epvario/epvario.github.io/downloads/hardware/index.html

EPV

- Introduction
- Features
- Usage
- Configurator
- Build Instructions
- Downloads
- GitHub (https://github.com/epvario)

### Case, Backplates, Buttons:

- printable Case STL Files (https://github.com/epvario/hardware/tree/main/rev3)

### Hardware Files:

- download Gerber / Production Files / BOM / xwCPL (https://github.com/epvario/hardware/tree/main/rev3/production_files)

### PCB Design Files:

- download KiCad Design files (https://github.com/epvario/hardware/tree/main/rev3/kiCad)
- PCB Layout reference (https://github.com/epvario/hardware/tree/main/rev3/layout)

#### ON THIS PAGE

- Case, Backplates, Buttons: (https://epvario.github.io/downloads/hardware/#case-backplates-buttons)
- Hardware Files: (https://epvario.github.io/downloads/hardware/#hardware-files)
- PCB Design Files: (https://epvario.github.io/downloads/hardware/#pcb-design-files)
- Introduction (https://epvario.github.io/introduction)
- Features (https://epvario.github.io/features)
- Build Instructions (https://epvario.github.io/buildinstructions)
- Usage (https://epvario.github.io/usage)
- How To (https://epvario.github.io/howto)
- Configurator (https://epvario.github.io/config)
- Downloads (https://epvario.github.io/downloads)
  - Firmware (https://epvario.github.io/downloads/firmware)
  - AGL Data (https://epvario.github.io/downloads/agl)
  - Hardware (https://epvario.github.io/downloads/hardware)

Powered by Zola (https://www.getzola.org) and Goyo (https://github.com/hahwul/goyo)
