epvario/epvario.github.io/images/EP_flight.jpg

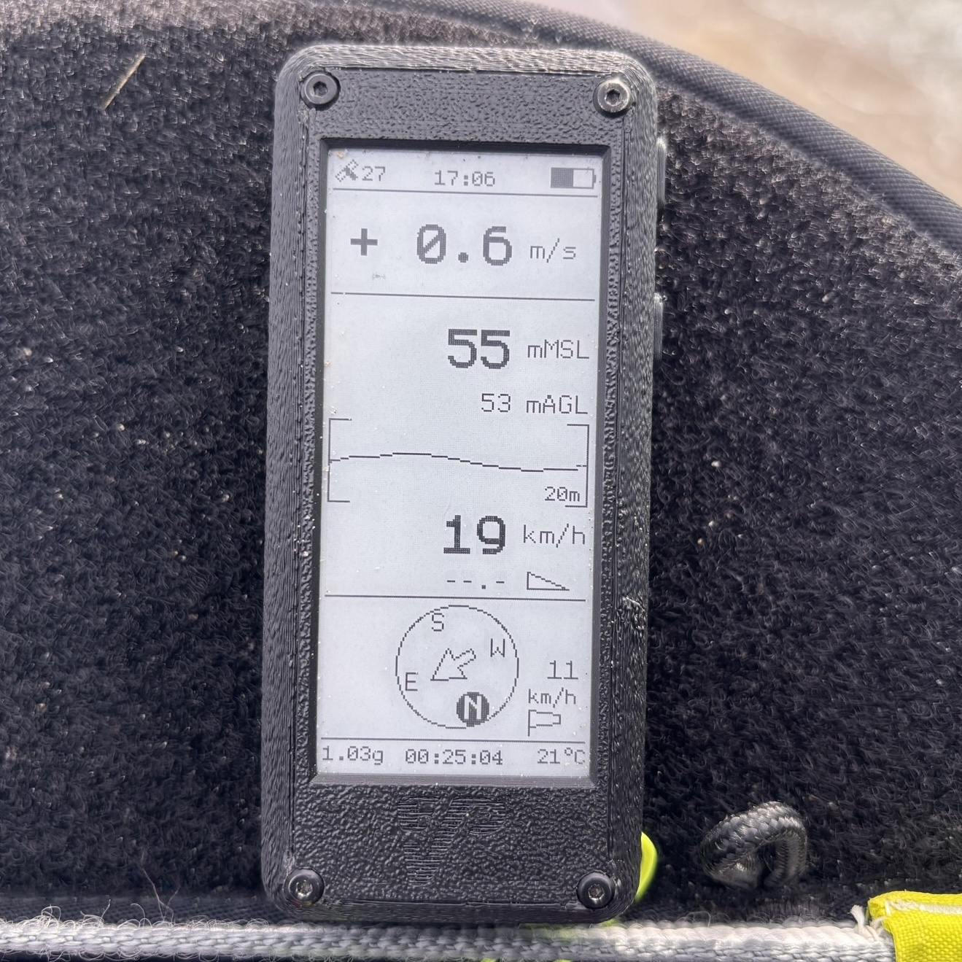
images/EP_flight.jpg
