epvario/epvario.github.io/images/EP_stats.jpg

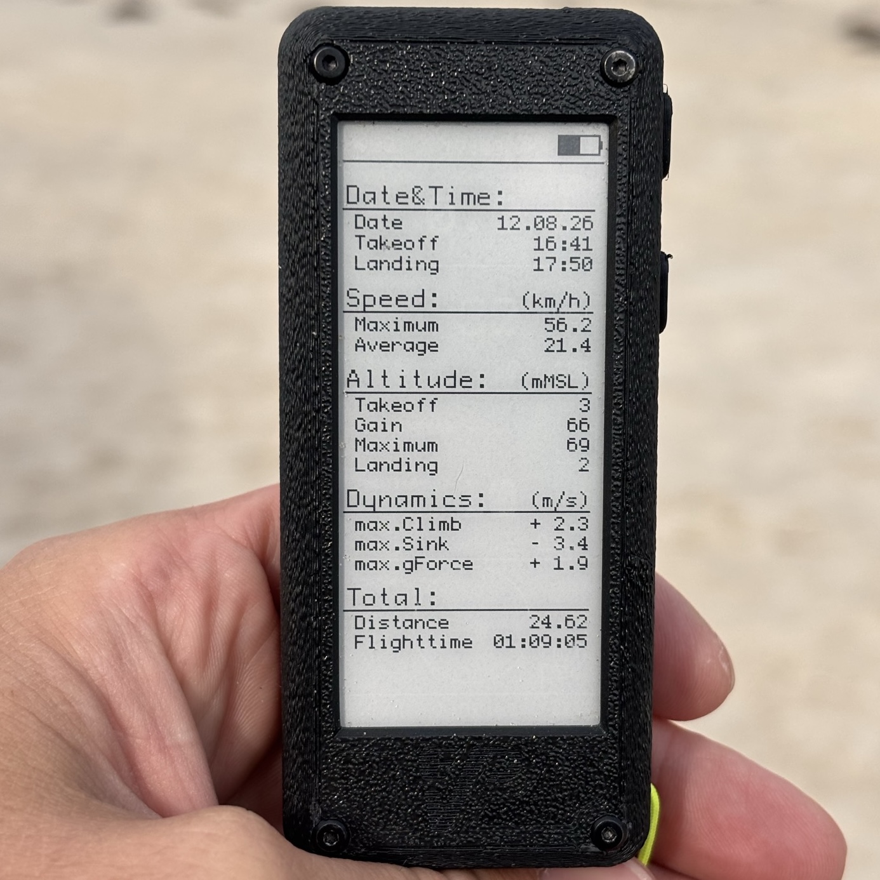
images/EP_stats.jpg
