epvario/epvario.github.io/images/epv-inflight.jpg

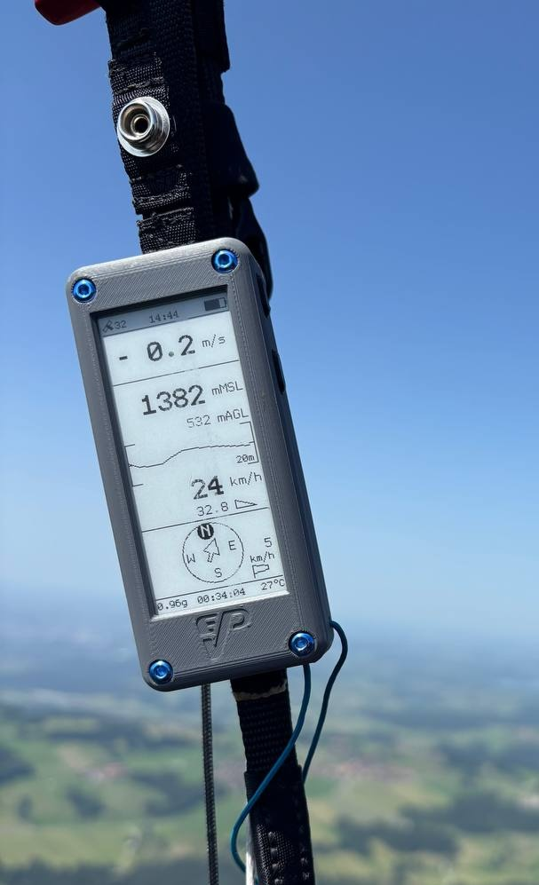
images/epv-inflight.jpg
