epvario/epvario.github.io/images/epv_display_elements.png

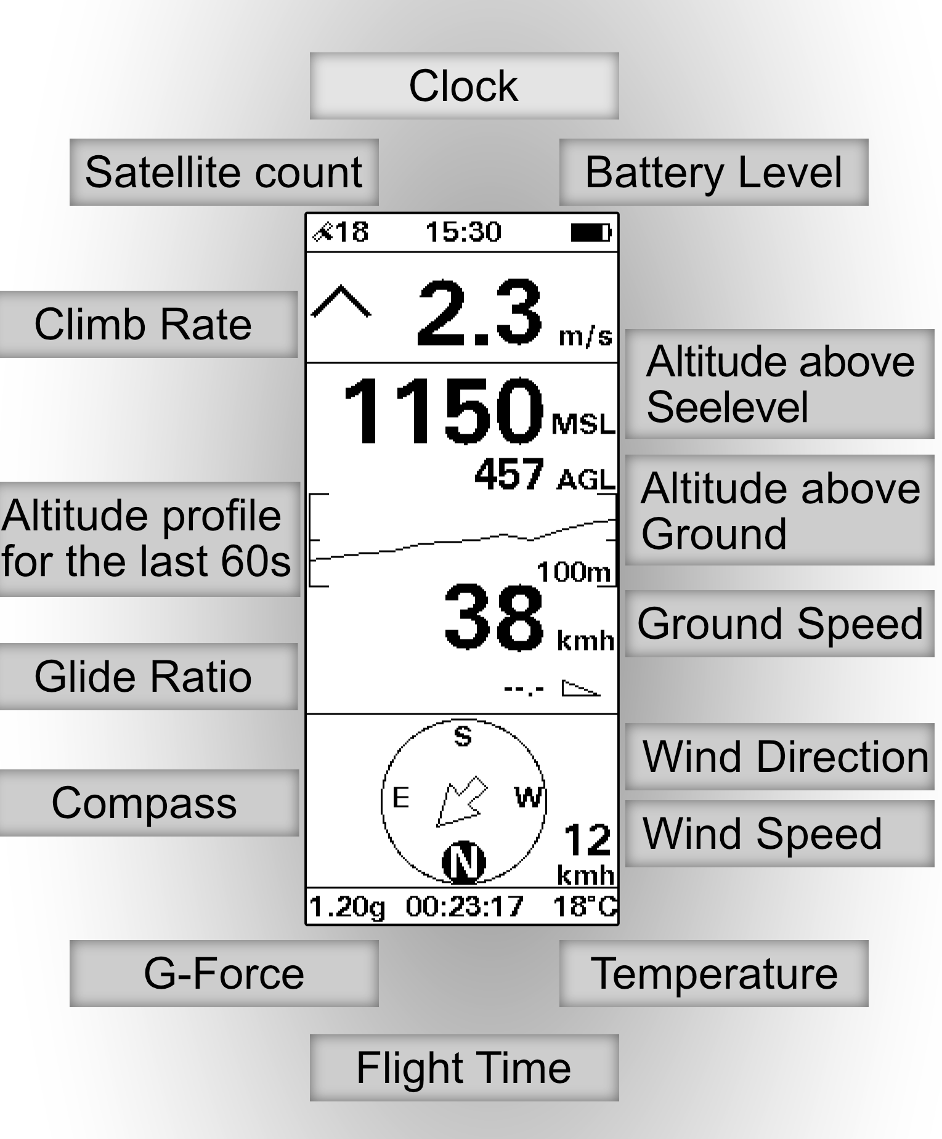
images/epv_display_elements.png
