epvario/epvario.github.io/images/epv_layout.png

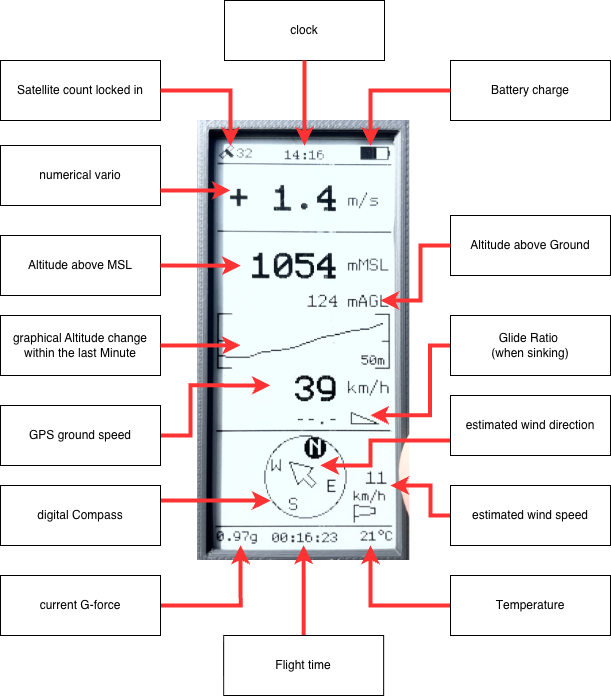
images/epv_layout.png
