epvario/epvario.github.io/images/epv_sim_flight.png

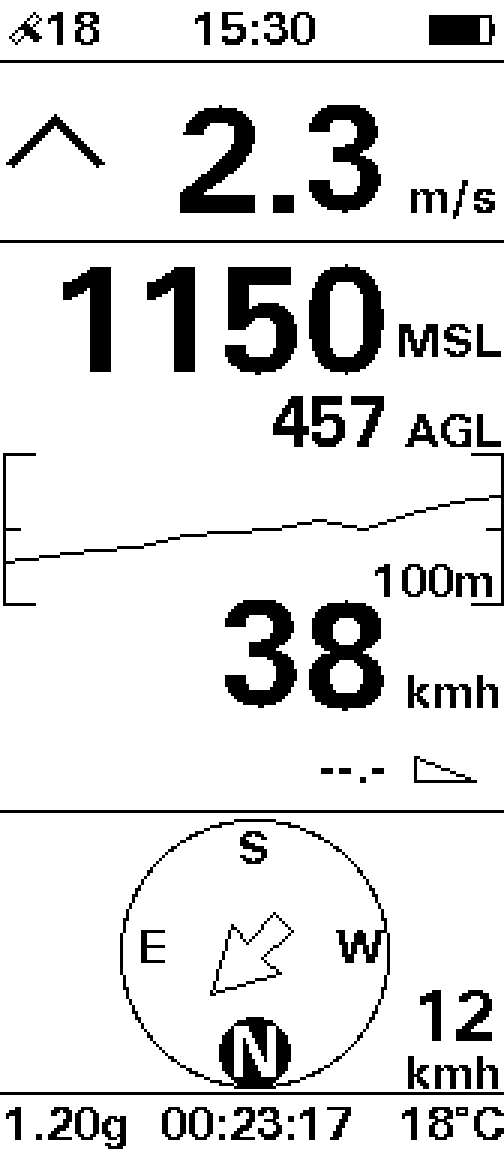
images/epv_sim_flight.png
