epvario/epvario.github.io/images/epv_sim_landscape.png

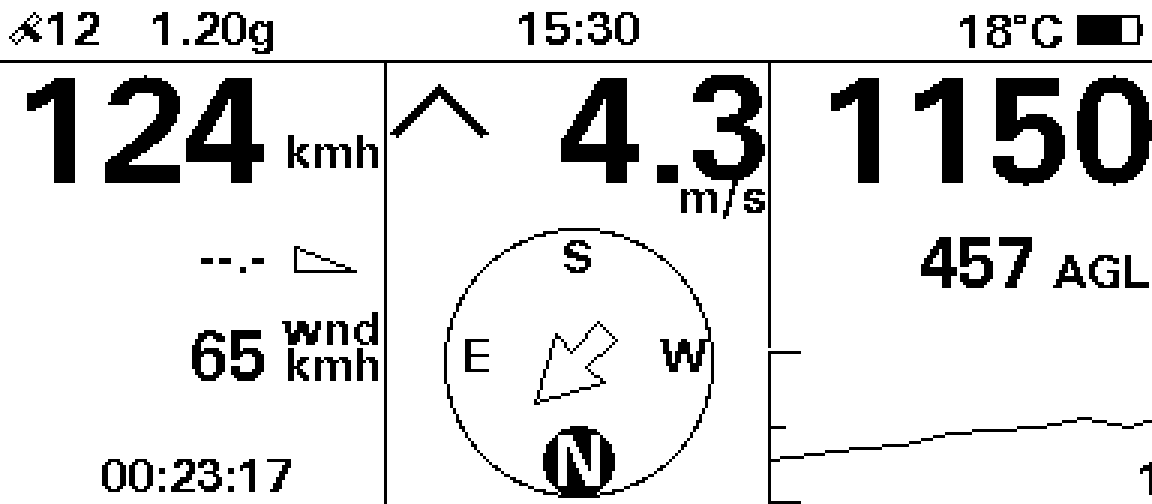
images/epv_sim_landscape.png
