epvario/epvario.github.io/images/output_stats.png

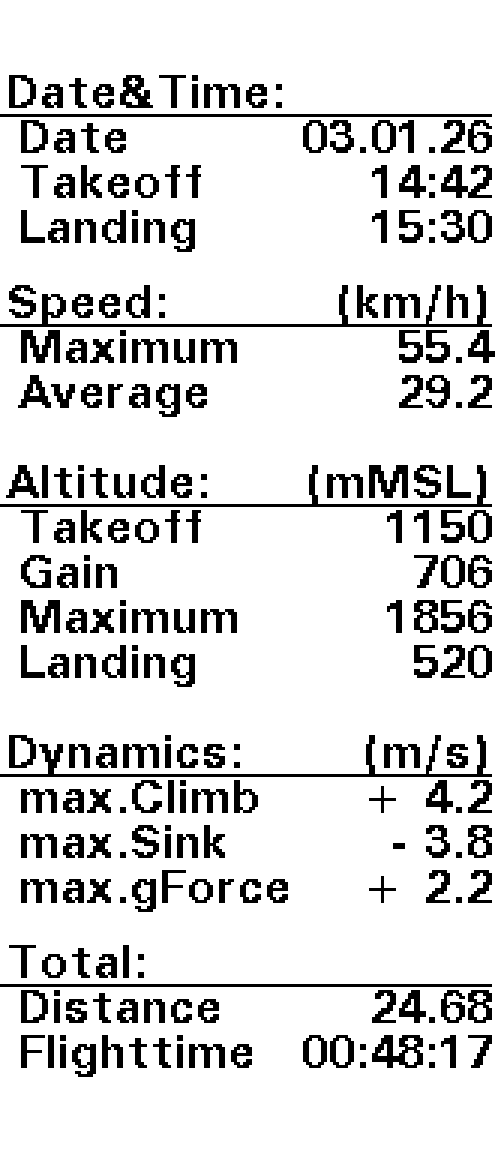
images/output_stats.png
