epvario/epvario.github.io/images/pcb_back.png

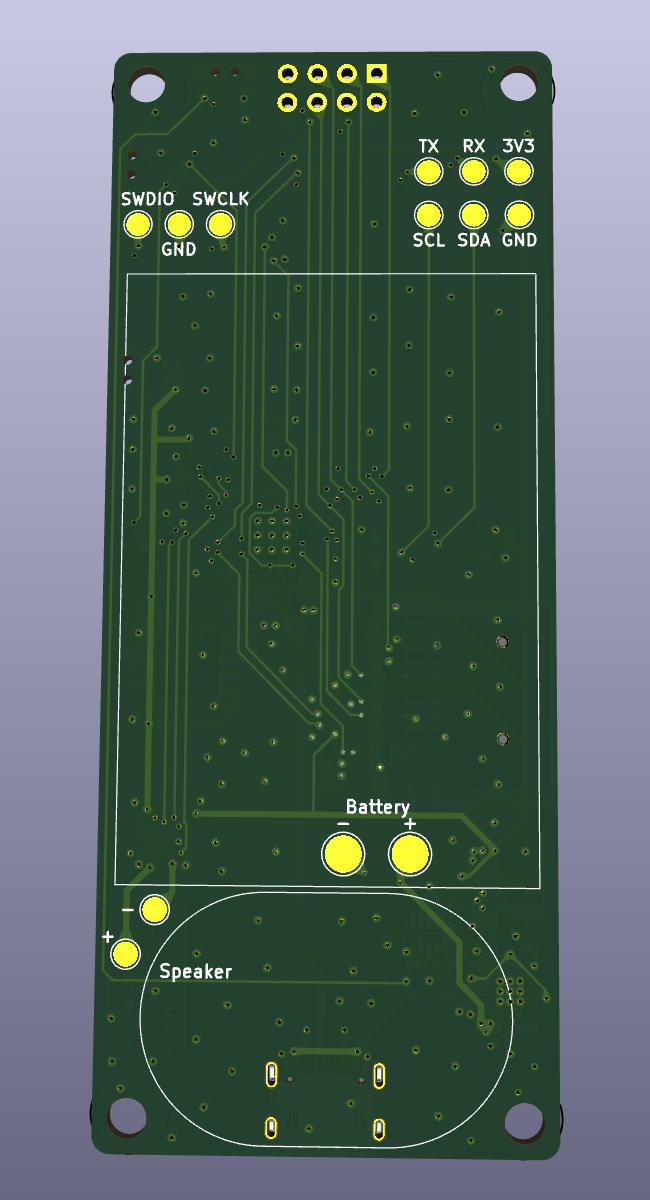
images/pcb_back.png
