epvario/epvario.github.io/images/pcb_front.png

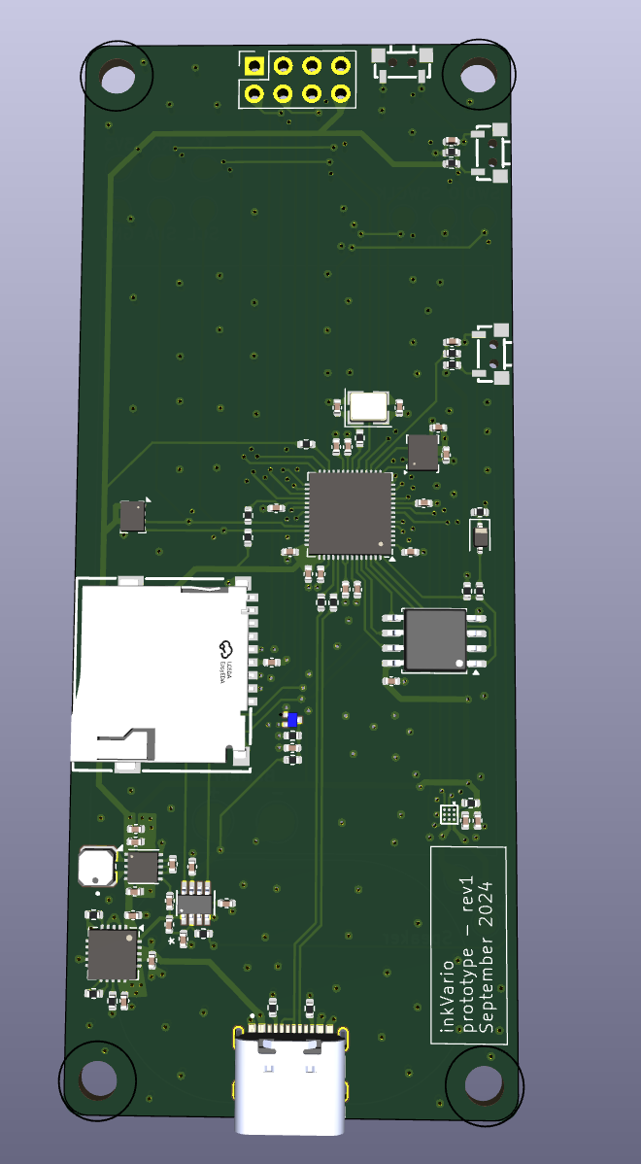
images/pcb_front.png
