epvario/epvario.github.io/images/pcb_rail.png

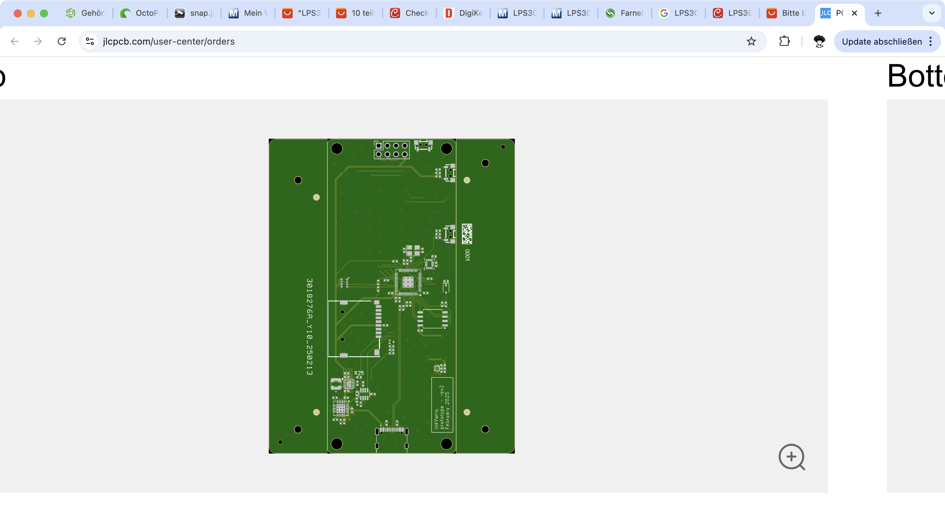
images/pcb_rail.png
