epvario/epvario.github.io/images/rev3.jpg

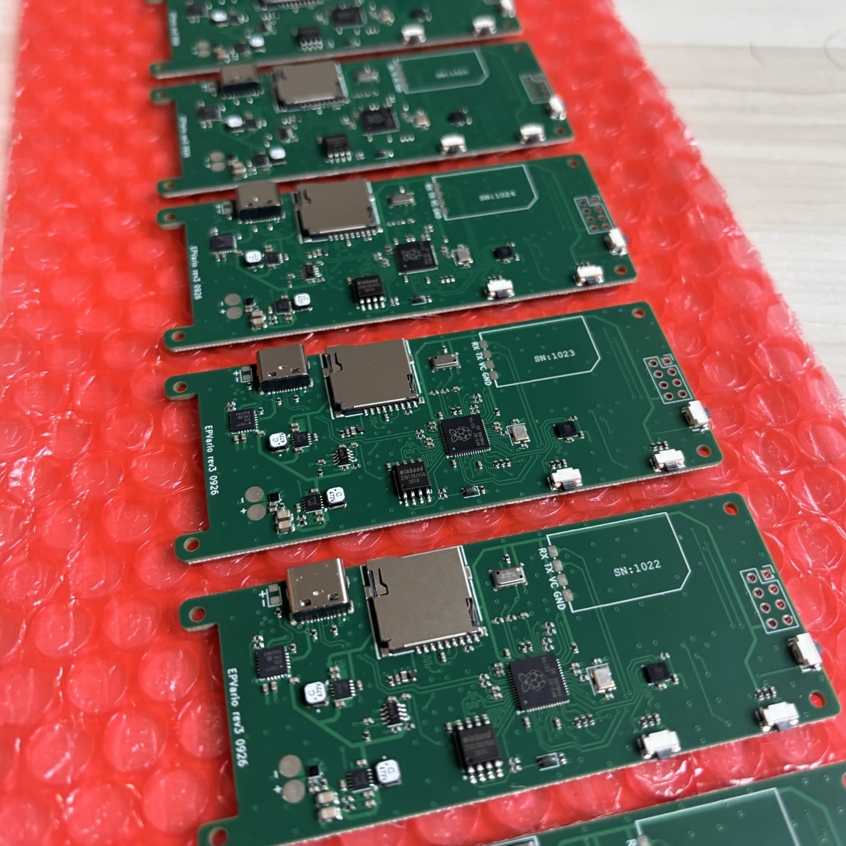
images/rev3.jpg
