epvario/epvario.github.io/images/rev3_render.png

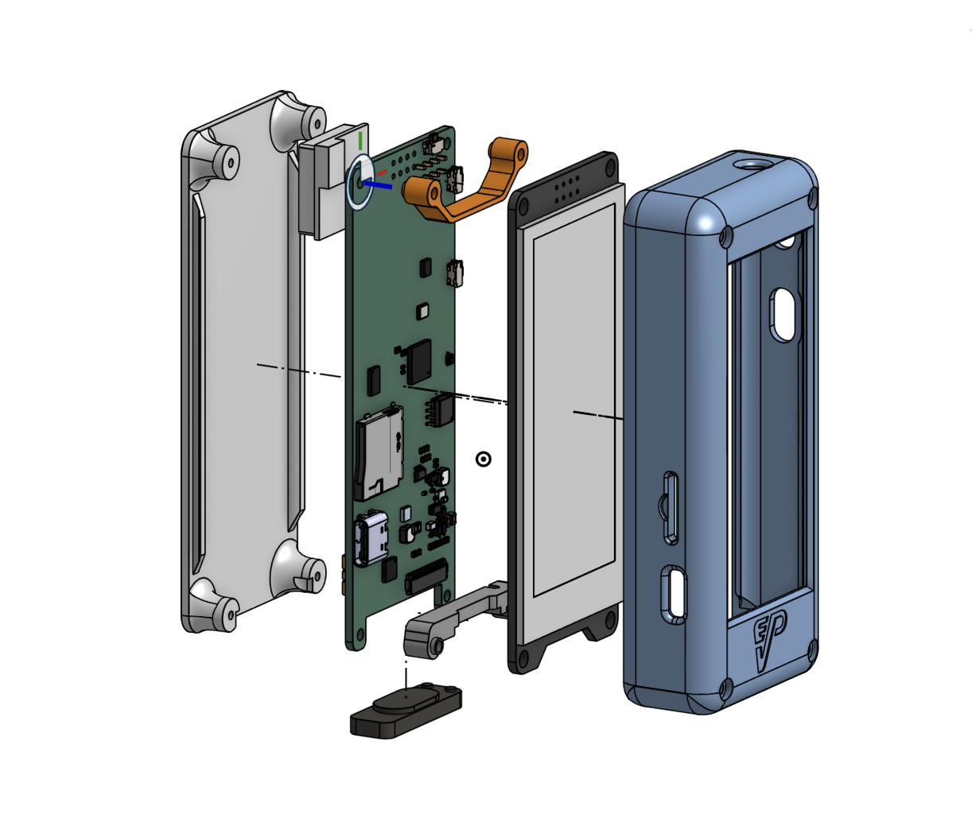
images/rev3_render.png
