epvario/epvario.github.io/images/srtm.jpg

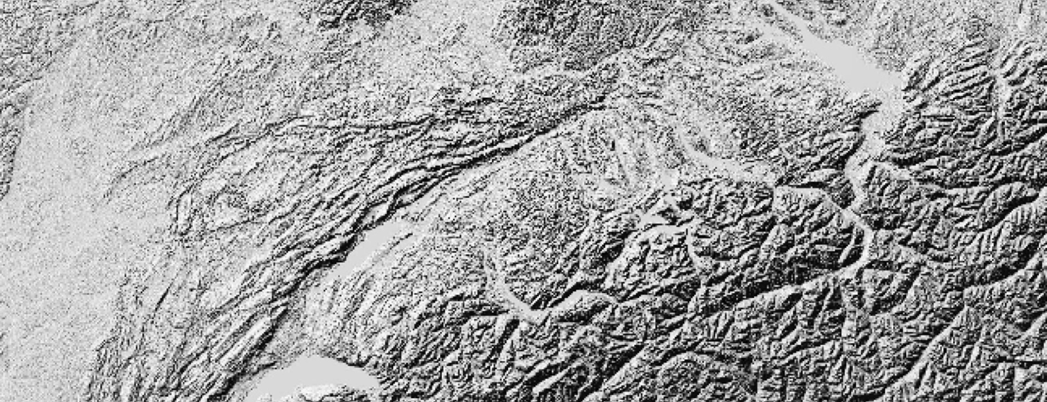
images/srtm.jpg
