epvario/epvario.github.io/images/TFTvsEP.jpg

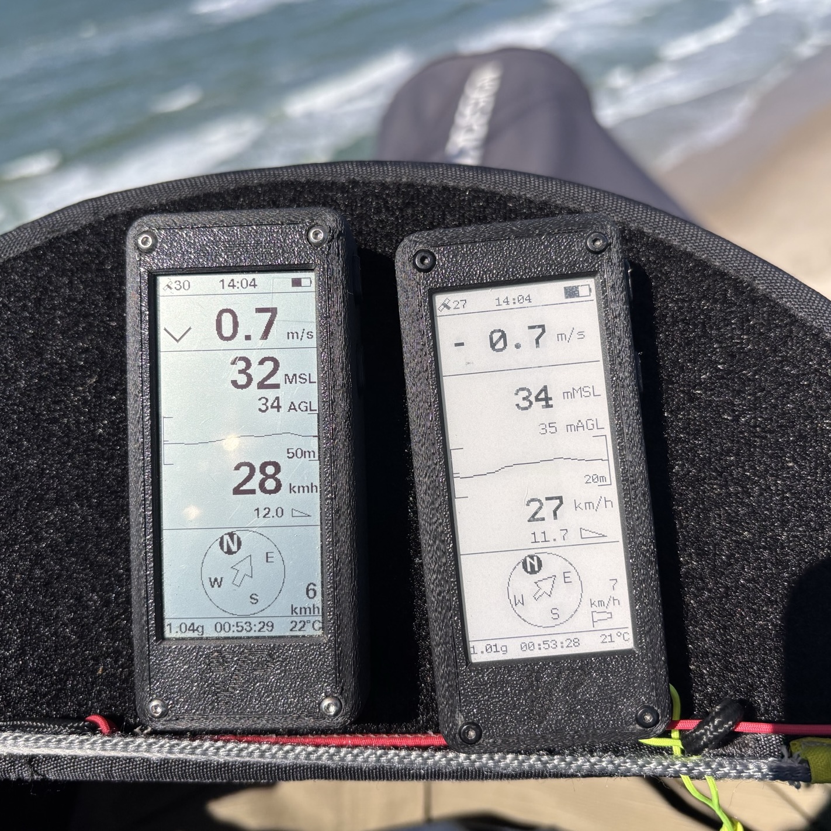
images/TFTvsEP.jpg
