epvario/epvario.github.io/case/distance_helper_bottom.stl

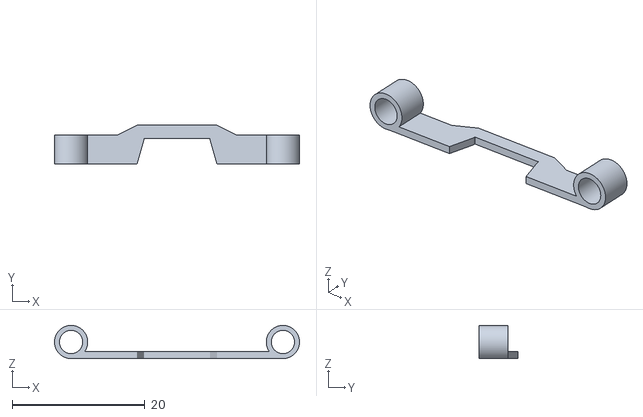
[picture p16: CAD file, 2026-10-16]
case/distance_helper_bottom.stl
36.9 x 5.80 x 5.00
