epvario/epvario.github.io/case/backplate_lock_v16.3.stl

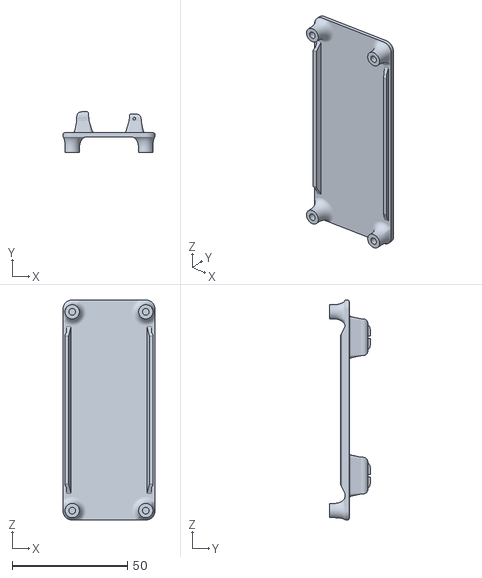
[picture p17: CAD file, 2026-10-16]
case/backplate_lock_v16.3.stl
39.9 x 17.6 x 95.4
