epvario/epvario.github.io/case/v18.6_2mm_iph5 - distance_helper_top.stl

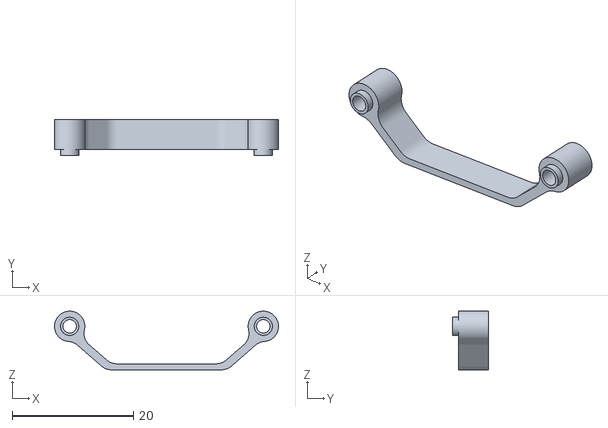
[picture p18: CAD file, 2026-10-16]
case/v18.6_2mm_iph5 - distance_helper_top.stl
36.9 x 6.00 x 9.67
