epvario/epvario.github.io/case/v18.6_2mm_iph5 - backplate_v2_clean.stl

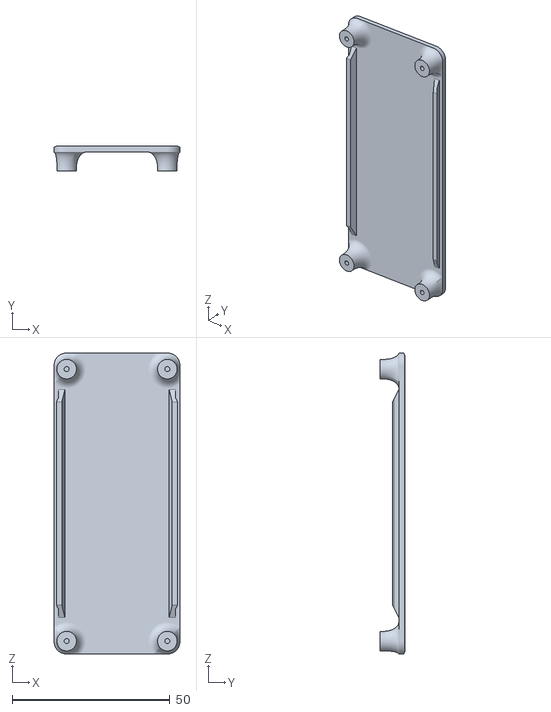
[picture p19: CAD file, 2026-10-16]
case/v18.6_2mm_iph5 - backplate_v2_clean.stl
39.9 x 8.00 x 95.4
