epvario/epvario.github.io/case/distance_helper_top.stl

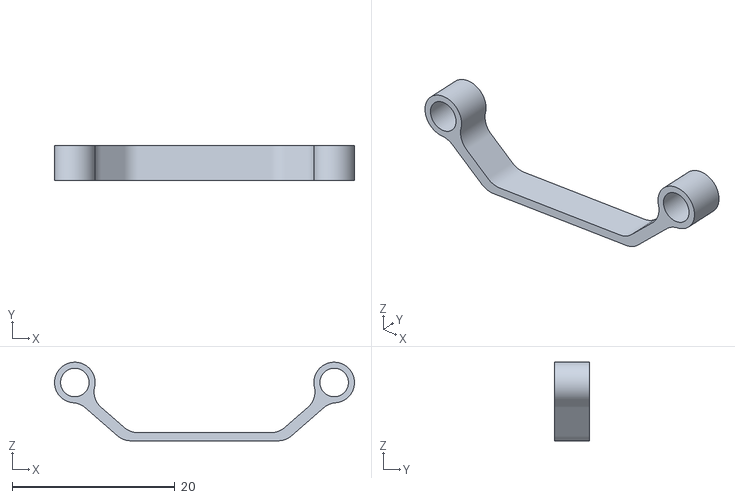
[picture p20: CAD file, 2026-10-16]
case/distance_helper_top.stl
36.9 x 4.30 x 9.67
