epvario/epvario.github.io/case/v18.6_2mm_iph5 - case.stl

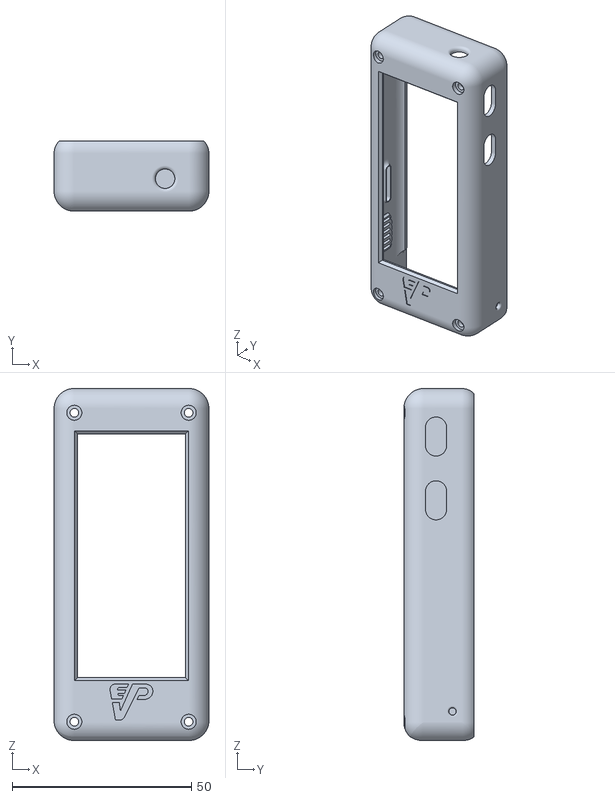
[picture p21: CAD file, 2026-10-16]
case/v18.6_2mm_iph5 - case.stl
43.2 x 19.6 x 98.2
