epvario/epvario.github.io/case/backplate_clean_v16.2.stl

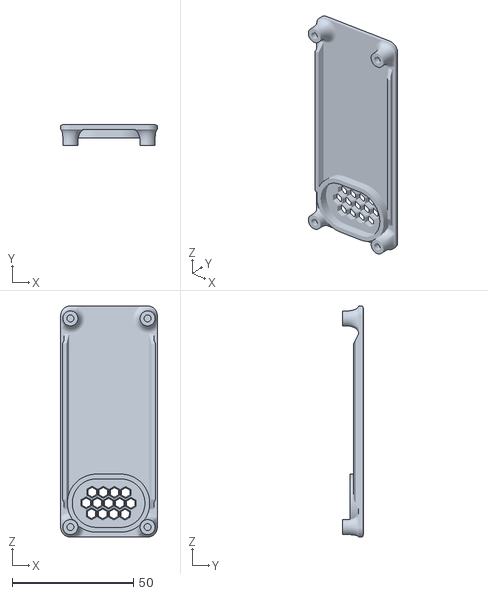
[picture p22: CAD file, 2026-10-16]
case/backplate_clean_v16.2.stl
39.9 x 8.60 x 95.4
