epvario/epvario.github.io/case/v18.6_2mm_iph5 - buttons.stl

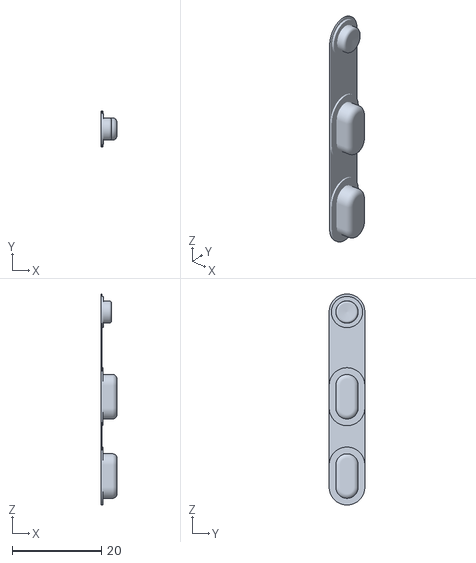
[picture p23: CAD file, 2026-10-16]
case/v18.6_2mm_iph5 - buttons.stl
3.60 x 8.00 x 47.3
