epvario/epvario.github.io/case/backplate_straps_v16.3.stl

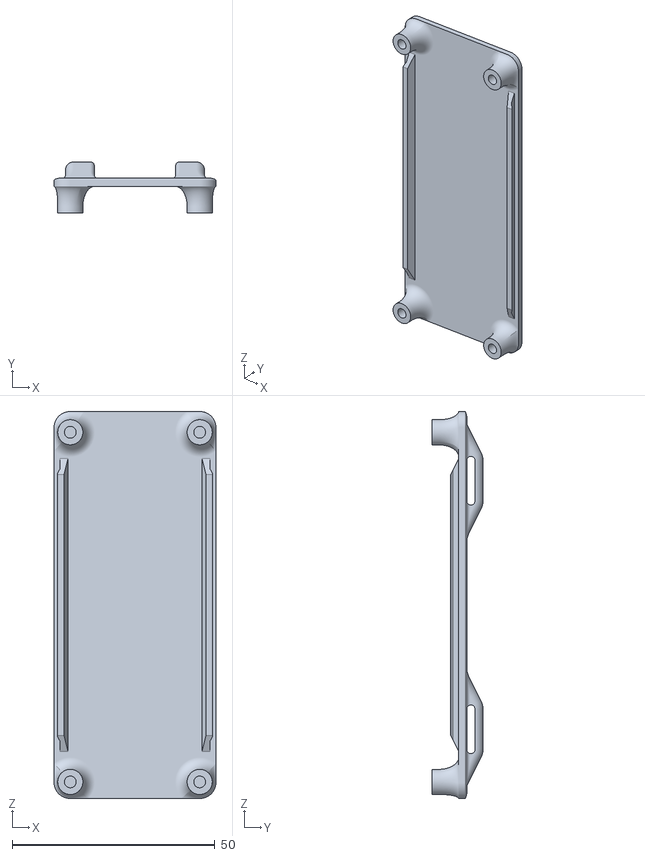
[picture p24: CAD file, 2026-10-16]
case/backplate_straps_v16.3.stl
39.9 x 12.6 x 95.4
