epvario/epvario.github.io/buildinstructions/index.html

EPV

- Introduction
- Features
- Usage
- Configurator
- Build Instructions
- Downloads
- GitHub (https://github.com/epvario)

## 1: Hardware sourcing

See our hardware repository for the latest information and files: https://github.com/epvario/hardware

Feel free to reach out to us for components i.e. mainboard as some are easier to purchase in higher volume.

## 2: 3D printing the files

- Case, Backplate, mounting brackets:
  - Material: PLA+, ABS, Greentec Pro
  - Layer-height: 0.12
  - Walls: 4
  - Infill: 15%
  - Draw a fuzzy Skin on the outside with Settings:
    - Generator Mode: Displacement
    - noise type: Classic
    - point distance: 0.35
    - thickness: 0.08
  - example 3MF file (https://epvario.github.io/buildinstructions/to-be-uploaded)
- Buttons:
  - Material: TPU
  - Layer-height: 0.20
  - example 3MF file (https://epvario.github.io/buildinstructions/to-be-uploaded)

`! depending on your printer fine tuning, you might need to trim/clean the edges or re-drill the holes a bit

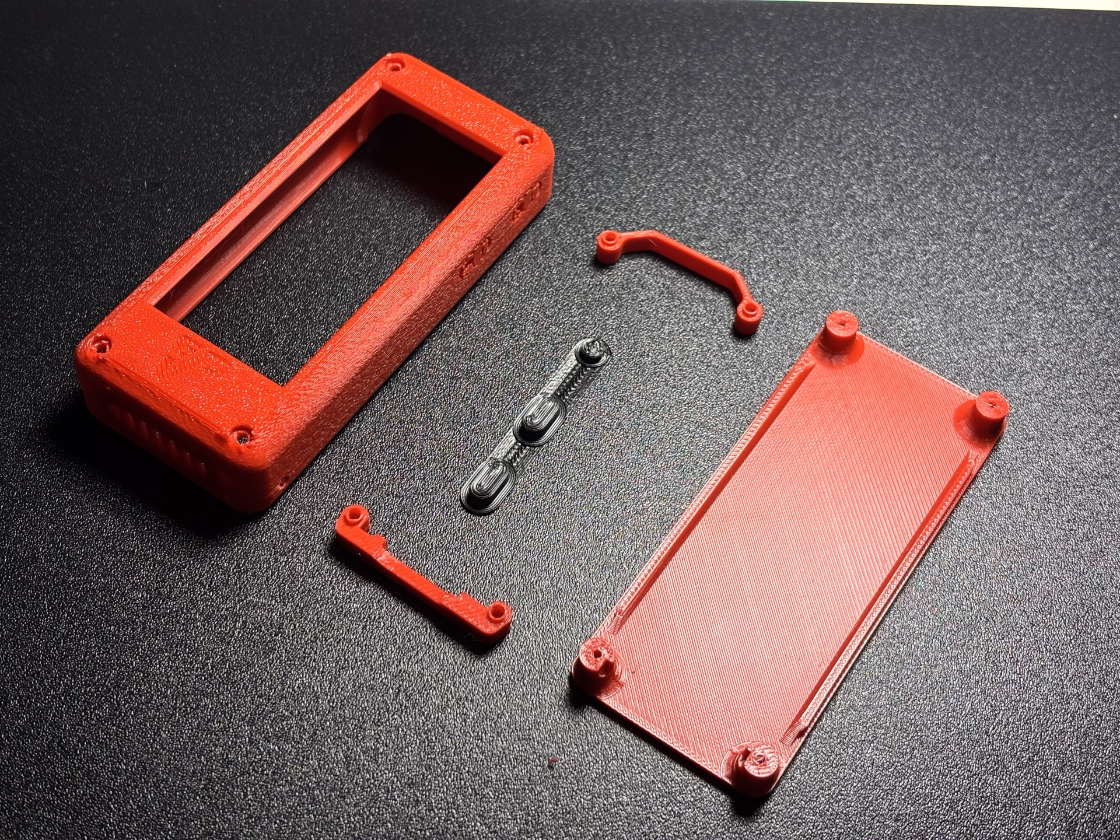
[picture p25: images/assembly/case_parts.jpg]
case_parts
All parts: 

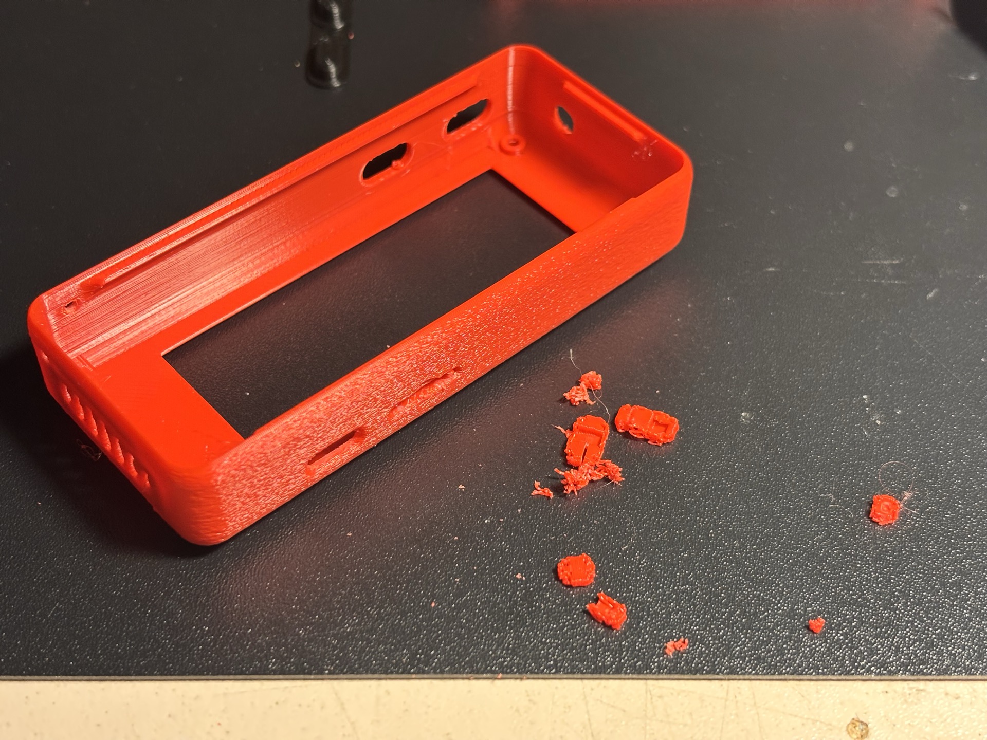
[picture p26: images/assembly/case_supports.jpg]
case_supports
Remove supports, clean edges: 

`

## 3: Mainboard

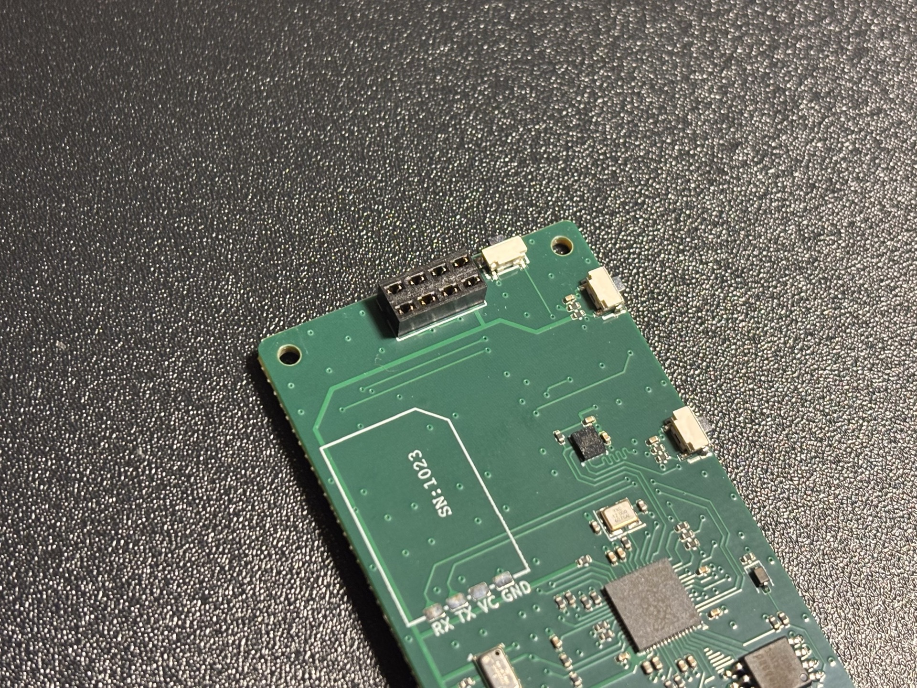
[picture p27: images/assembly/mainboard_connector.jpg]
mainboard_connector
- solder the display connector to the top of the mainboard: 
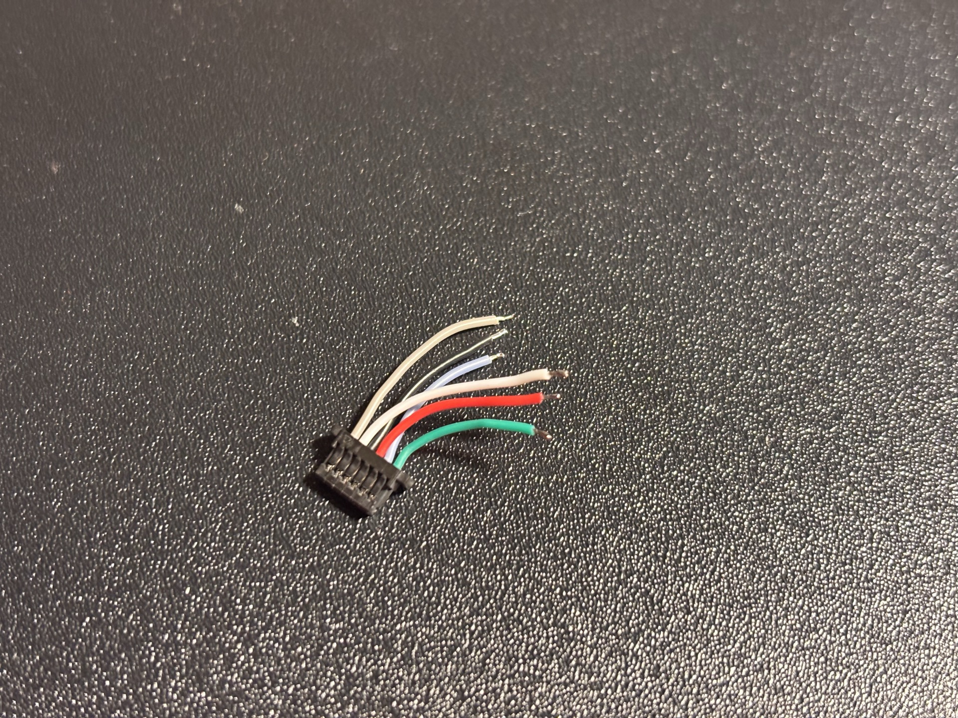
[picture p28: images/assembly/GPS_wire.jpg]
GPS_wire
- prepare the GPS wire: 
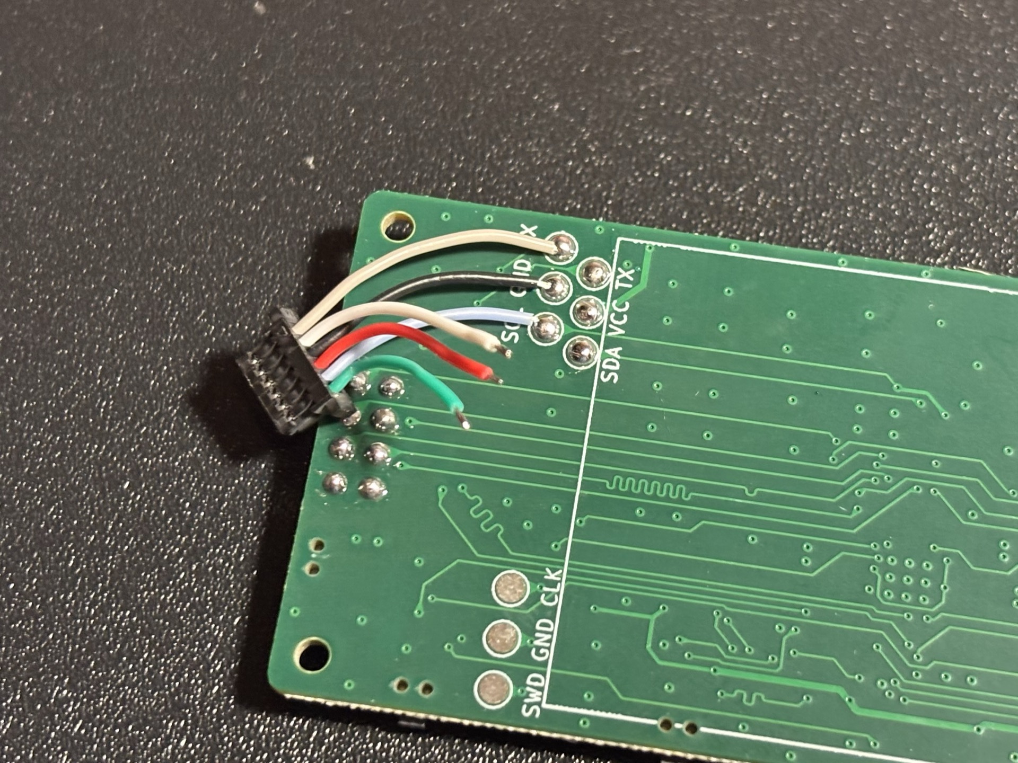
[picture p29: images/assembly/mainboard_wire_soldered_half.jpg]
mainboard_wire_soldered_half
- solder the wire to the UART and I2C pads on the backside: 
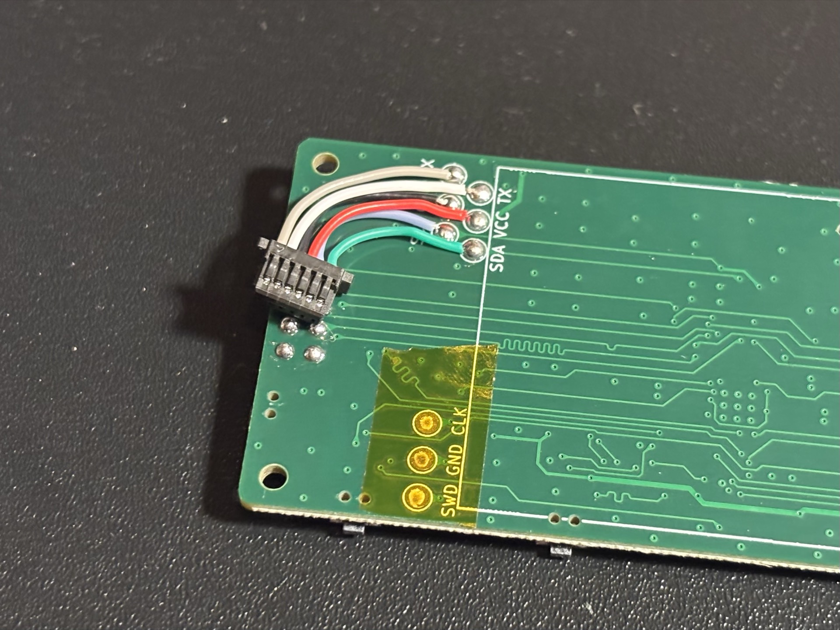
[picture p30: images/assembly/mainboard_wire_soldered.jpg]
mainboard_wire_soldered
- isolate the debug probe pads, those are only needed for development: 
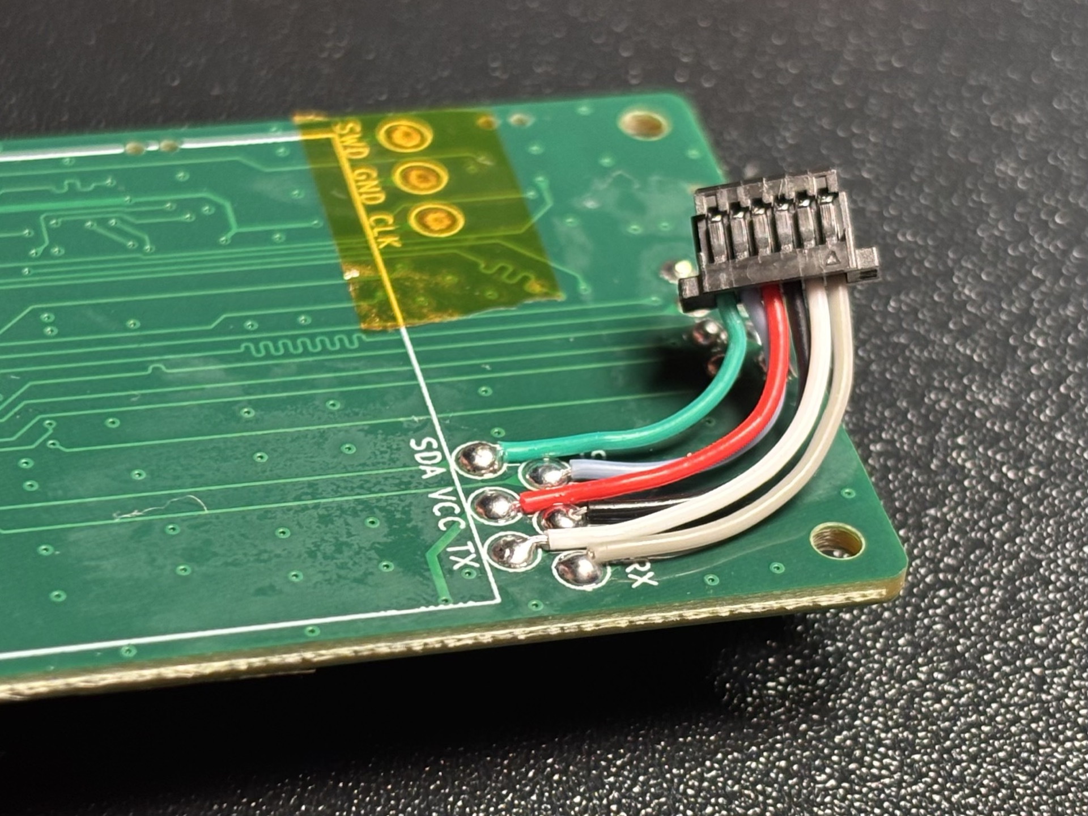
[picture p31: images/assembly/mainboard_wire_flat.jpg]
mainboard_wire_flat
- ensure a flat profile: 
- Add the battery connection terminal
- Optionally: add a 5V LED to the pads next to the USB-C port as charging indicator

## 4: Display

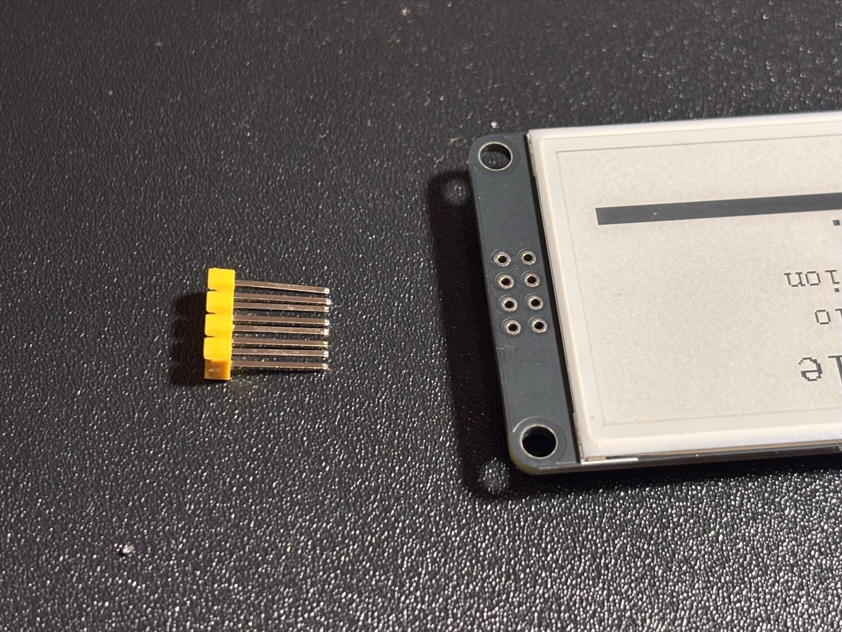
[picture p32: images/assembly/display_8pin.jpg]
display_8pin
The 8 pins need to be shorted to fit. First slide them to the very end: 

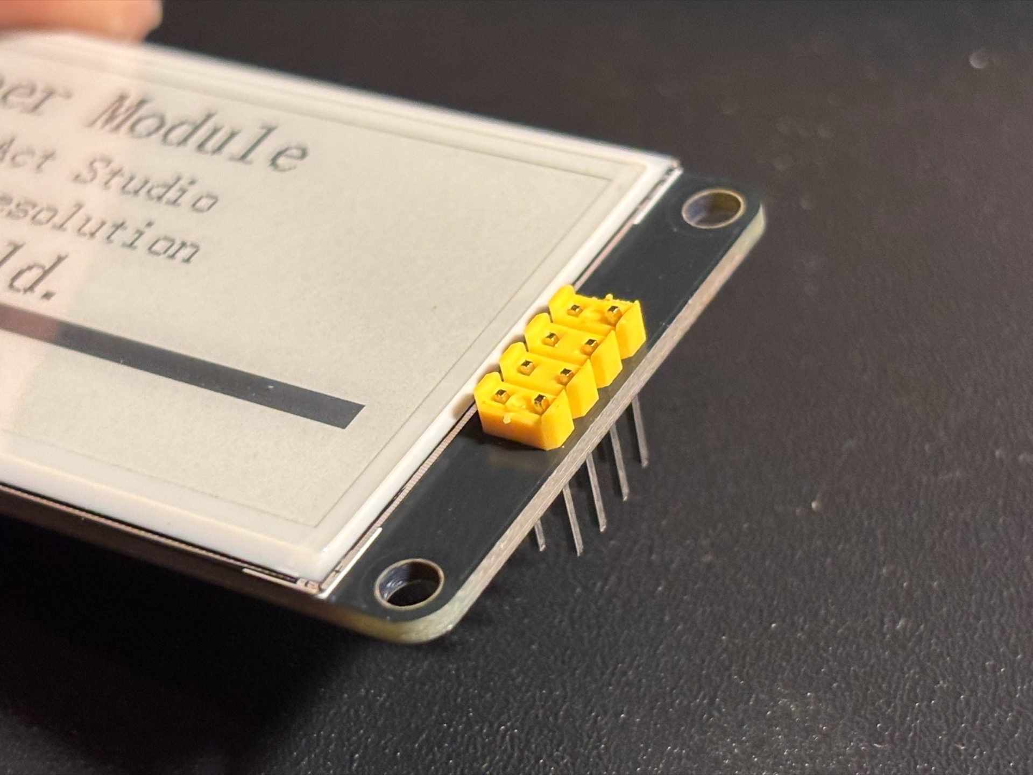
[picture p33: images/assembly/display_8pin_2.jpg]
display_8pin_2
- then insert them from the top: 
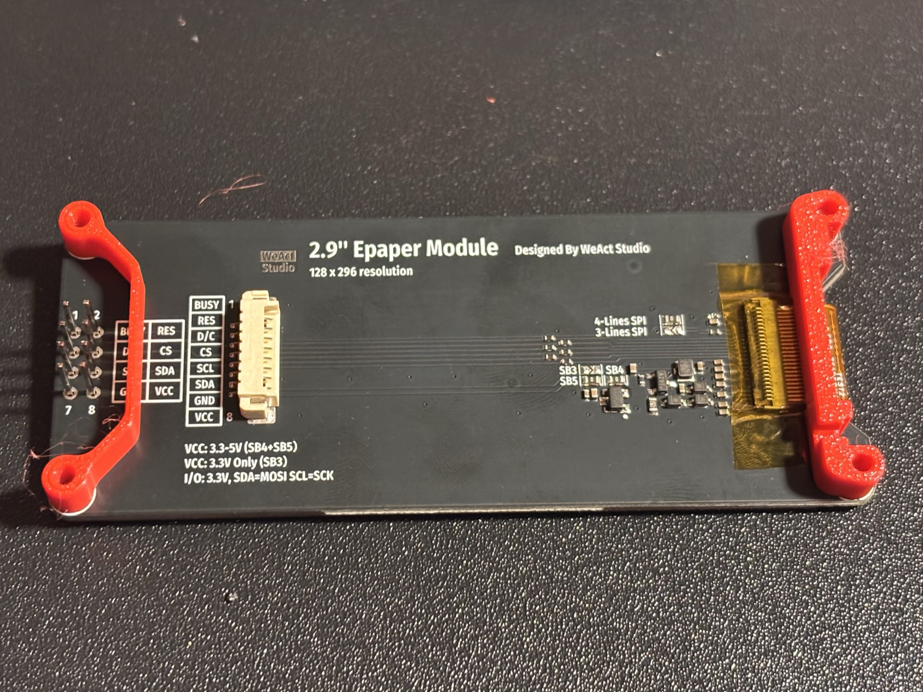
[picture p34: images/assembly/display_brackets.jpg]
display_brackets
- attach the mounting brackets to the display: 
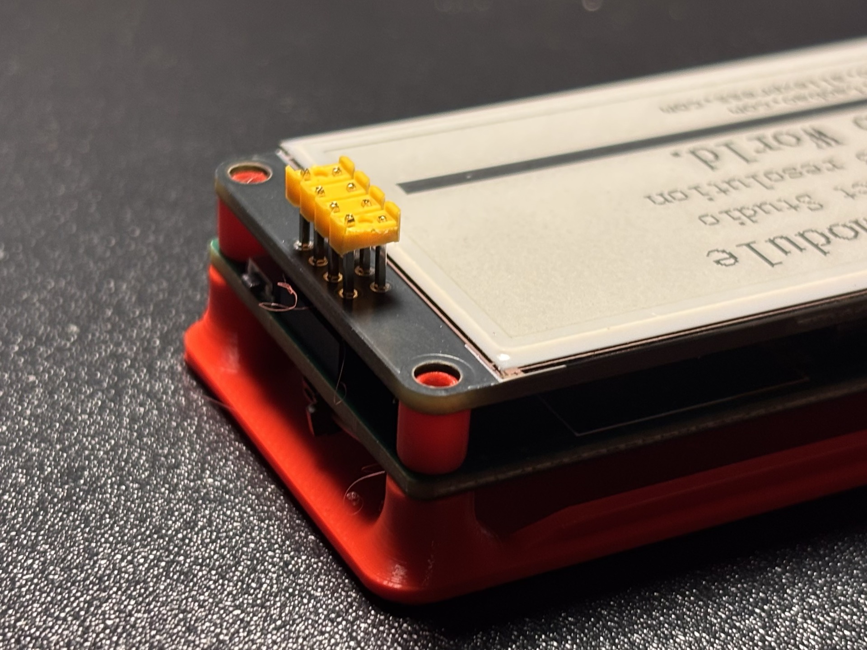
[picture p35: images/assembly/display_connected.jpg]
display_connected
- connect the two PCBs: 
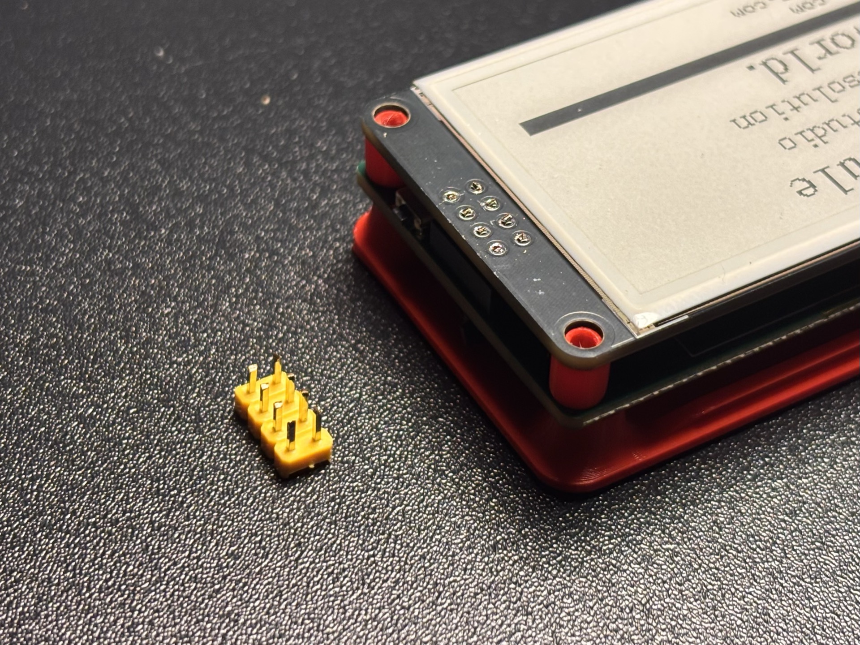
[picture p36: images/assembly/display_shortened_pins.jpg]
display_shortened_pins
- shorten the pins on the top side: 
- Optionally but recommended:
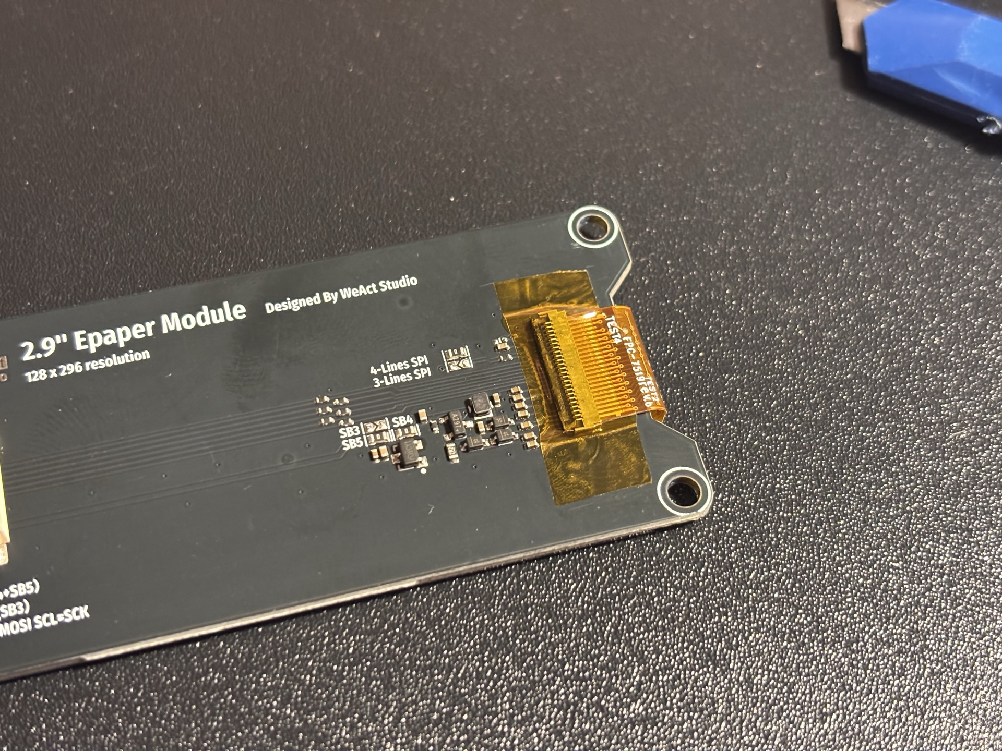
[picture p37: images/assembly/display_FPC.jpg]
display_FPC
  - isolate the FPC connector on the display bottom side: 
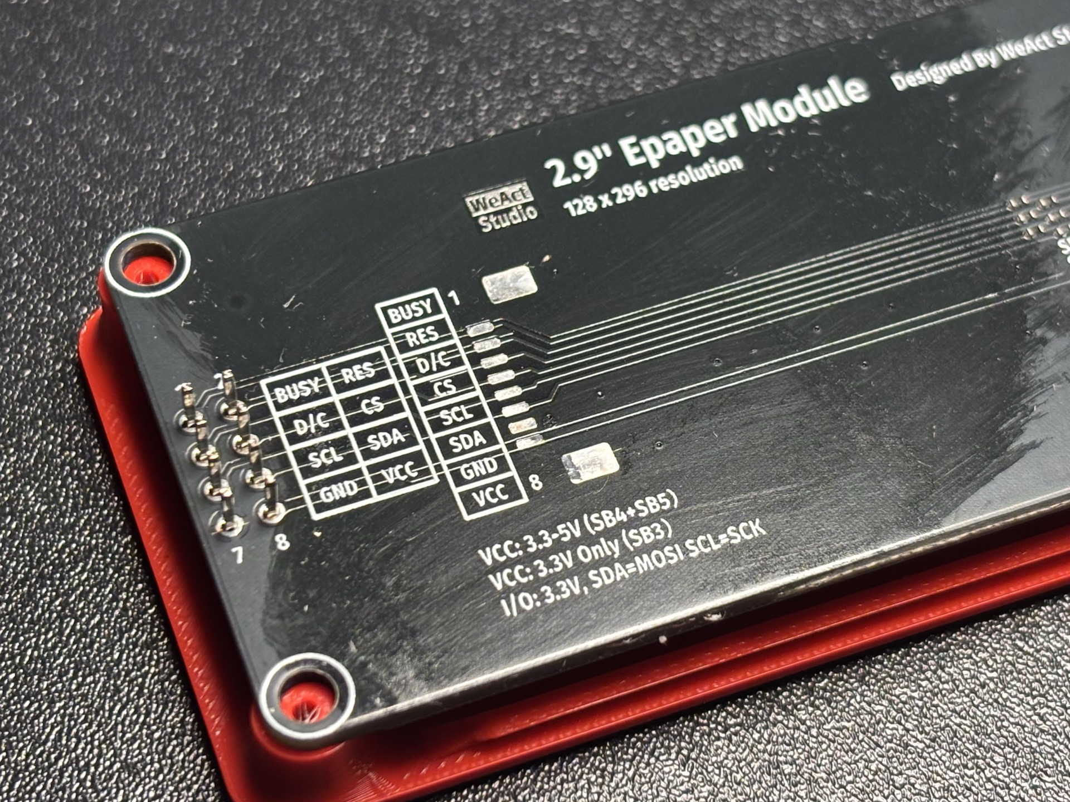
[picture p38: images/assembly/display_socket_removed.jpg]
display_socket_removed
  - remove the 8pin socket if you plan to add the FANET RF Module: 
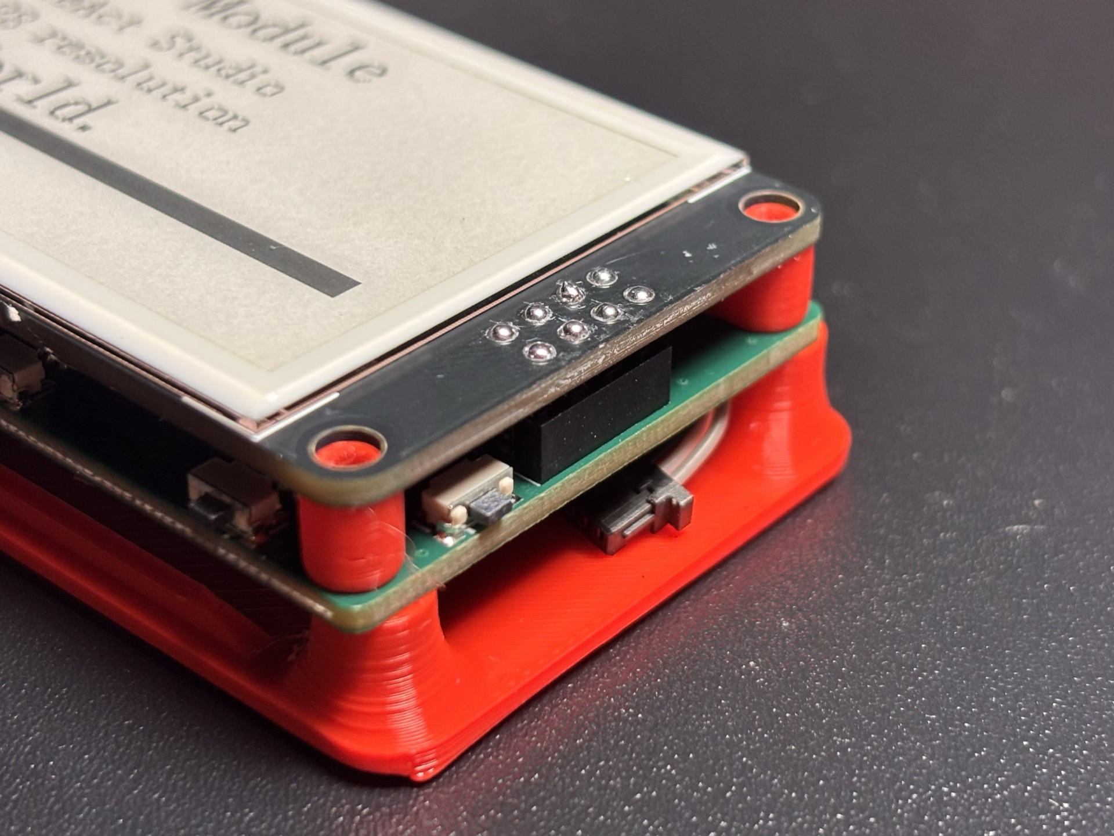
[picture p39: images/assembly/display_soldered.jpg]
display_soldered
  - Also ensure a flat solder joint here: 

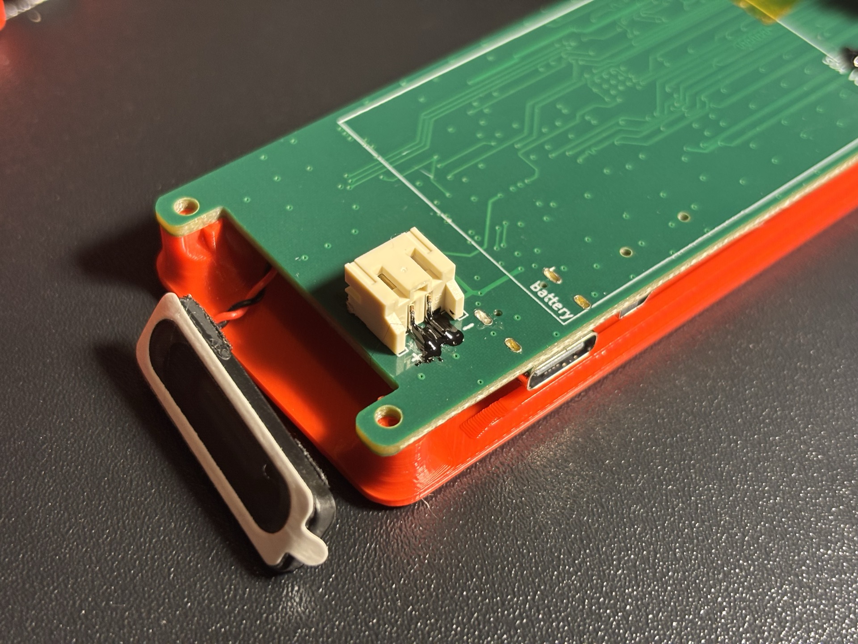
[picture p40: images/assembly/mainboard_battery_terminal.jpg]
mainboard_battery_terminal


## 5: Speaker

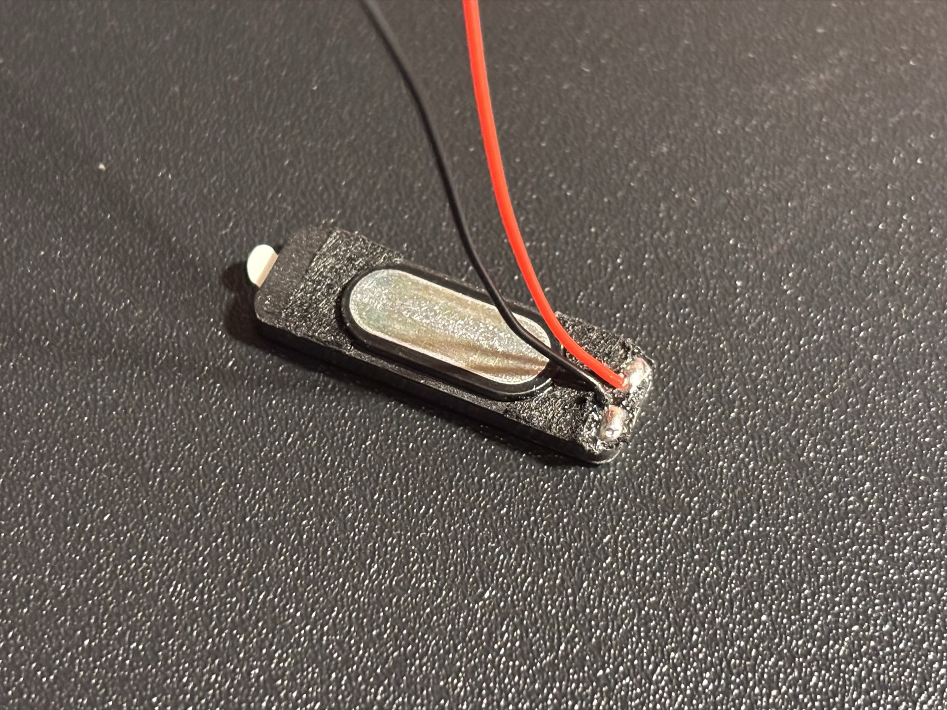
[picture p41: images/assembly/2809_speaker.jpg]
2809_speaker
- the wires need to be located to the middle like so: 

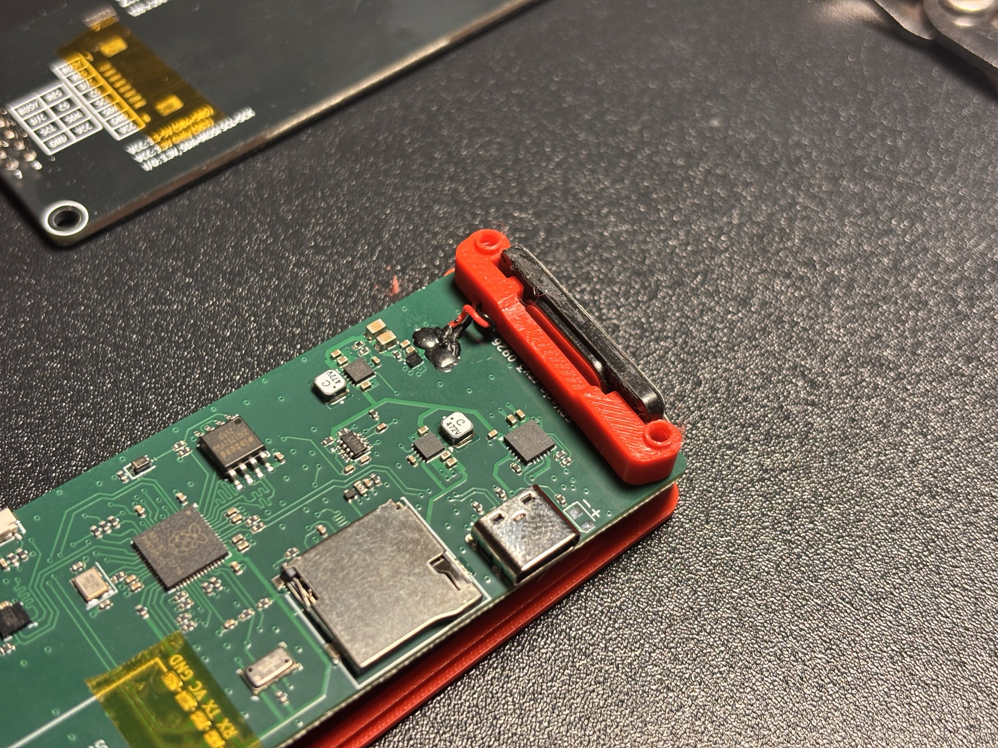
[picture p42: images/assembly/speaker_placement.jpg]
speaker_placement


## 6: Isolation

We use liquid tape to create a thin isolation of solder joints, especially all 3.3V/VBAT connections.

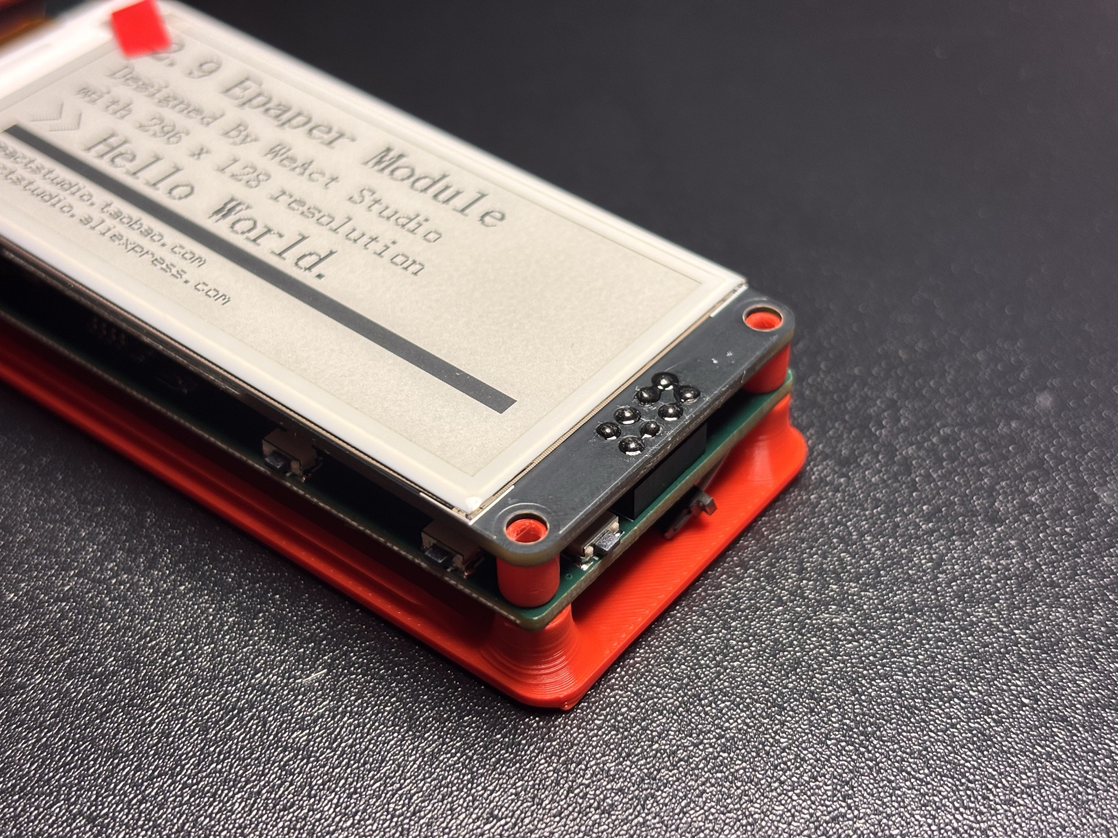
[picture p43: images/assembly/display_isolated.jpg]
display_isolated


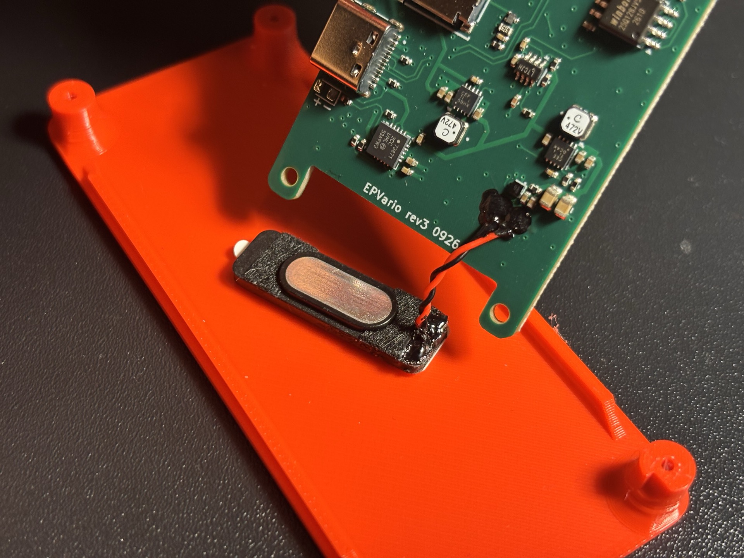
[picture p44: images/assembly/speaker_isolated.jpg]
speaker_isolated


## 7: final assembly

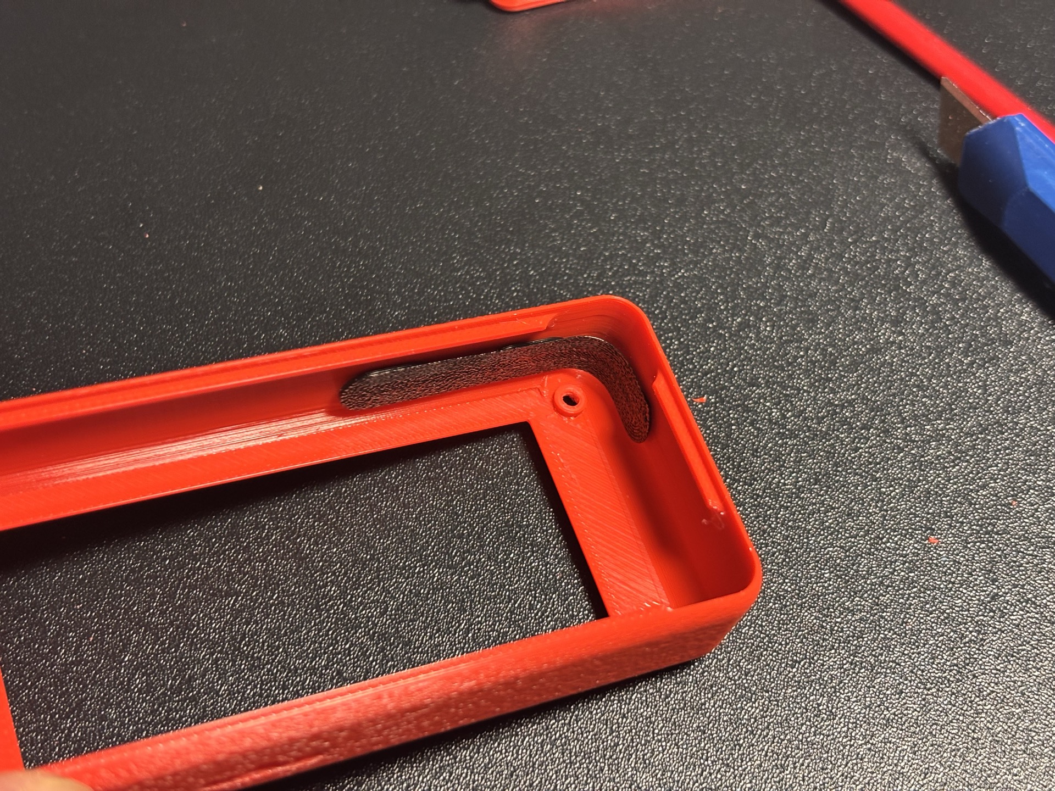
[picture p45: images/assembly/case_buttons.jpg]
case_buttons
- insert the buttons and ensure they are moving freely: 
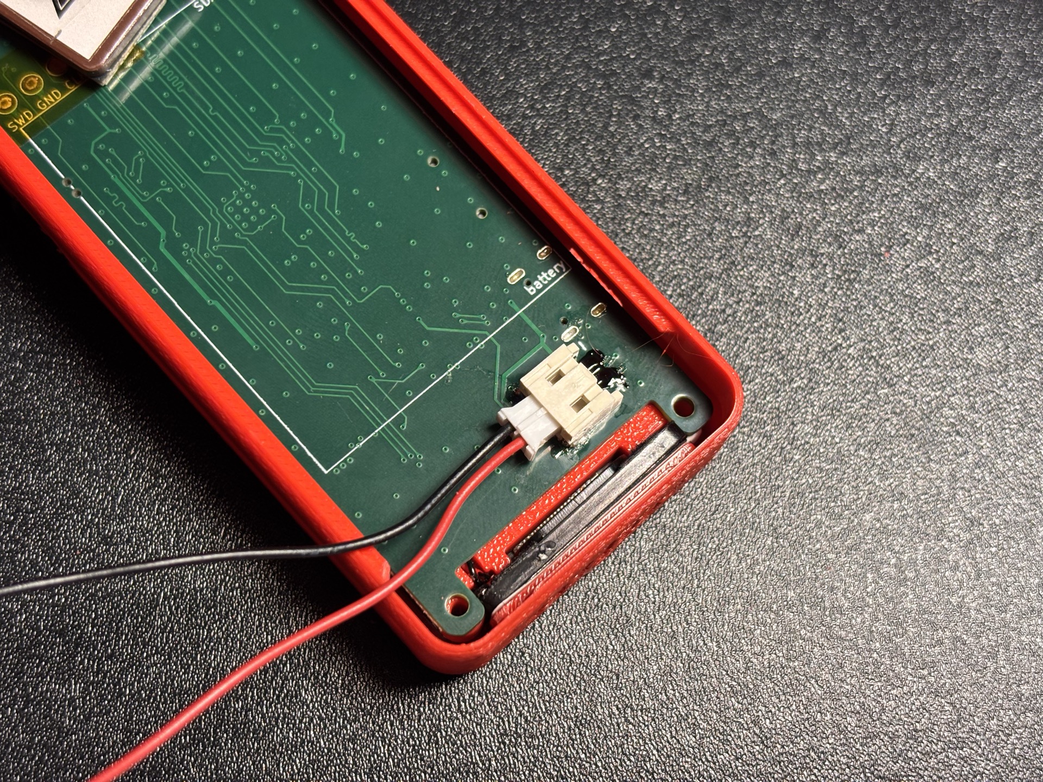
[picture p46: images/assembly/battery_connected.jpg]
battery_connected
- double check the battery polarization is correct: 
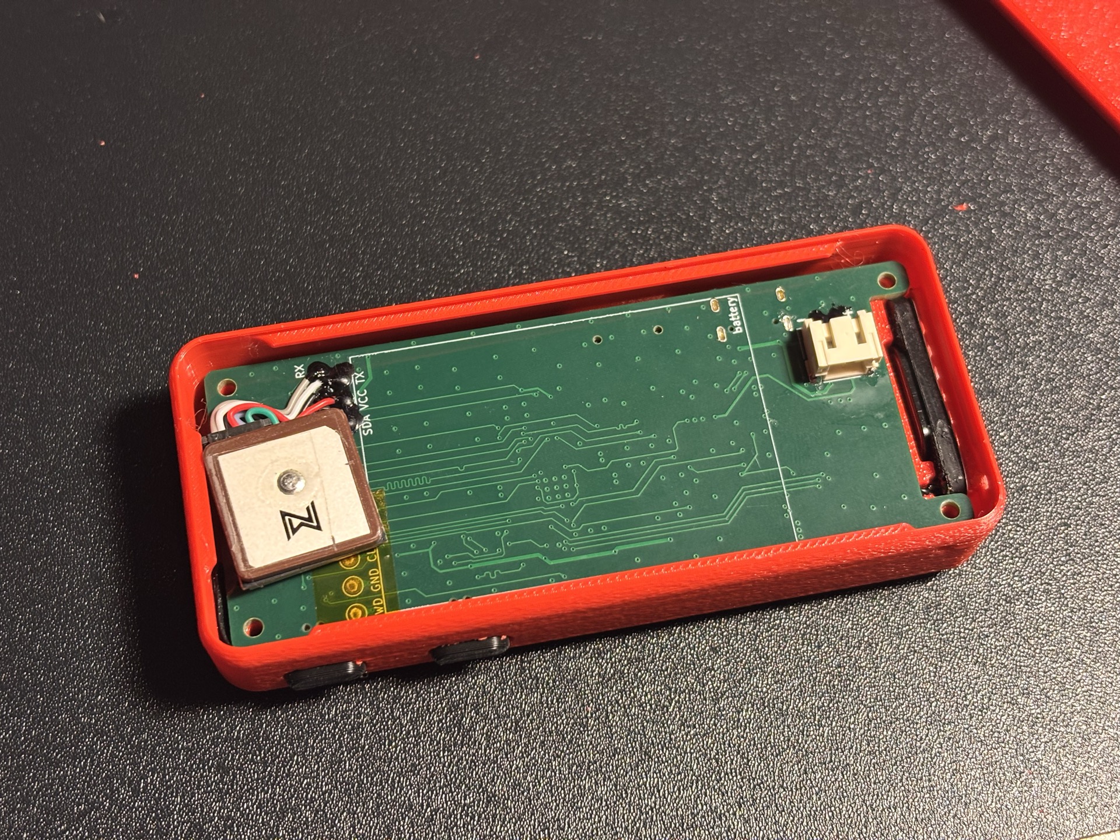
[picture p47: images/assembly/assembly_wo_battery.jpg]
assembly_wo_battery
- connect GPS and place on the top 
- fix the battery in place with some double sided tape
- add a little loop to secure the device on your harness
- close the backplate, put in the screws and finalize your mounting variation

## 8: initial firmware flashing and first power up

- connect your EPV to a USB-C power source and give it a minute to initialize the battery management and charge the battery
- create your config.txt and upload to the SD card along with AGL data to your flying region
  - config-builder-here
- enter the bootsel mode by pressing volume-up and power on for 4 seconds
- find a USB mass storage device called RPI-RP2
- copy an EPV firmware.uf2 file to the USB device download-here
- wait until the EPV reboots and splash screen shows up
- initialize the sensors how-to

## 9: Basic tests

- can the volume be controlled with the side buttons
- is the G-Force display ~1.0 with no motion?
- blow gently into an opening to create a pressure difference -> climb rate should change and vario should beep
- are you getting any SAT lock when outside?
- once altitude changes to AMSL, with more than 8 sats, you can even test flight detection with a little ride on your bike :)

## assembly tips

- the GPS antenna is the metal/silver plate on top of the brown ceramic plate. Its tuned by those scratches you might see - which is absolutely normal. Put some thin tape (aka Tesa) on top of that to "protect" the tune and surface.
- use a lighter and some gentle heat on areas of the printed parts, where the surface appears brighter / matte.
- use a powerdrill to screw in a dummy screw quickly and let it rest for a minute. The friction will melt the plastic and create a nice thread around the screw.

#### ON THIS PAGE

- 1: Hardware sourcing (https://epvario.github.io/buildinstructions/#1-hardware-sourcing)
- 2: 3D printing the files (https://epvario.github.io/buildinstructions/#2-3d-printing-the-files)
- 3: Mainboard (https://epvario.github.io/buildinstructions/#3-mainboard)
- 4: Display (https://epvario.github.io/buildinstructions/#4-display)
- 5: Speaker (https://epvario.github.io/buildinstructions/#5-speaker)
- 6: Isolation (https://epvario.github.io/buildinstructions/#6-isolation)
- 7: final assembly (https://epvario.github.io/buildinstructions/#7-final-assembly)
- 8: initial firmware flashing and first power up (https://epvario.github.io/buildinstructions/#8-initial-firmware-flashing-and-first-power-up)
- 9: Basic tests (https://epvario.github.io/buildinstructions/#9-basic-tests)
- assembly tips (https://epvario.github.io/buildinstructions/#assembly-tips)
- Introduction (https://epvario.github.io/introduction)
- Features (https://epvario.github.io/features)
- Build Instructions (https://epvario.github.io/buildinstructions)
- Usage (https://epvario.github.io/usage)
- How To (https://epvario.github.io/howto)
- Configurator (https://epvario.github.io/config)
- Downloads (https://epvario.github.io/downloads)
  - Firmware (https://epvario.github.io/downloads/firmware)
  - AGL Data (https://epvario.github.io/downloads/agl)
  - Hardware (https://epvario.github.io/downloads/hardware)

Powered by Zola (https://www.getzola.org) and Goyo (https://github.com/hahwul/goyo)
