epvario/epvario.github.io/howto/index.html

EPV

- Introduction
- Features
- Usage
- Configurator
- Build Instructions
- Downloads
- GitHub (https://github.com/epvario)

#### How do I update my Vario for new features?

- when turned off, press and hold the power-button and volume-up-button for 5 seconds to enter flashing/bootsel mode.
- a USB-drive/mass storage device does now appear when plugged into a computer or phone
- copy your firmware.uf2 file to the RPI-RP2 drive
- the vario boots with the new firmware once completed
- unplug the vario

#### How do I get a recorded flight / IGC-file?

Your flight records are stored on the SD card and currently there is no access through the USB of the vario possible.

- turn the vario off and eject the SD card
- use a cardreader on your mobile or PC to access the card files

#### How to calibrate the sensors?

- to make the vario work starting RC15 and later you need to calibrate the IMU and magnetometer
- power up the vario and press and hold both volume buttons for 5 seconds within the first 30 seconds
- A new GUI will start, leading you through the process
    1. put the vario very steady on a table to calibrate the gyro - a beep will be sound once complete
    2. orient the vario on all faces, like displayed, the line is bottom, circles are up like "clouds"
    - place it steady on a flat surface
    - a beep will be sound once complete

#### How to get AGL data shown?

- turn the vario off and eject the SD card
- use a cardreader on your mobile or PC to access the card files
- go to the map here and download each tile you are flying at (one or multiple)
- extract each content (files like N46E010-019.HGT) to your SD card root (not a subfolder)
- insert SD card and turn on the vario
- wait for your SAT lock and observe your mAGL value
- done

#### How do I end an ongoing flight recoding immediately?

- to end a flight, like flight timer is running, you can press and hold both volume buttons for 1 second
- the flight mode will switch to "landed"
- IGC recording will stop gracefully
- post flight stats screen will be displayed
- if you are still flying (or still above 2m/s) a new flight will be detected automatically

#### How do I change my configuration?

- turn the vario off and eject the SD card
- use a cardreader on your mobile or PC to access the card files
- use our configurator here
- fill out the form and hit download to retrieve your config.txt
- save the config.txt to your SD card and insert into your vario
- done

#### How do I force-reset my vario?

If your vario stuck in any unexpected case like a filesystem issue, a bug or elsewhat you can power down your vario like so:

- press and hold the powerbutton and volume-UP button for 15 seconds
- the device will be force-powered-down from any state
- done, turn the vario on normally

#### ON THIS PAGE

- How do I update my Vario for new features? (https://epvario.github.io/howto/#how-do-i-update-my-vario-for-new-features)
- How do I get a recorded flight / IGC-file? (https://epvario.github.io/howto/#how-do-i-get-a-recorded-flight-igc-file)
- How to calibrate the sensors? (https://epvario.github.io/howto/#how-to-calibrate-the-sensors)
- How to get AGL data shown? (https://epvario.github.io/howto/#how-to-get-agl-data-shown)
- How do I end an ongoing flight recoding immediately? (https://epvario.github.io/howto/#how-do-i-end-an-ongoing-flight-recoding-immediately)
- How do I change my configuration? (https://epvario.github.io/howto/#how-do-i-change-my-configuration)
- How do I force-reset my vario? (https://epvario.github.io/howto/#how-do-i-force-reset-my-vario)
- Introduction (https://epvario.github.io/introduction)
- Features (https://epvario.github.io/features)
- Build Instructions (https://epvario.github.io/buildinstructions)
- Usage (https://epvario.github.io/usage)
- How To (https://epvario.github.io/howto)
- Configurator (https://epvario.github.io/config)
- Downloads (https://epvario.github.io/downloads)
  - Firmware (https://epvario.github.io/downloads/firmware)
  - AGL Data (https://epvario.github.io/downloads/agl)
  - Hardware (https://epvario.github.io/downloads/hardware)

Powered by Zola (https://www.getzola.org) and Goyo (https://github.com/hahwul/goyo)
