epvario/epvario.github.io/usage/index.html

EPV

- Introduction
- Features
- Usage
- Configurator
- Build Instructions
- Downloads
- GitHub (https://github.com/epvario)

## Pre-Takeoff:

- Press and hold the upper, power button for 3 seconds to turn the device on or off
- Use the side buttons to increase or decrease the volume level
- The Vario will now find your location, the SAT count on the top left will increase & the Flighttimer will show locating
- Once your position is set, the Flighttimer will show --:--:--
- At this stage the vario is in pre-takeoff mode, recoding the past 20 seconds to include your takeoff in the log

## Takeoff:

- Once groundspeed is above >2m/s for a duration of 5 seconds the vario will detect your takeoff.
- The flighttimer will start running and a 4-tone-climb sound will be noticable.
- Your position will be recorded continously

## Flying:

- The compass element will start working once a heading is obtained
- The wind estimator will deliver data (and continue updating) every full cycle has been flown
  - The gathered data will outage after 10min, so the information might disappear when flying into a single direction for longer time
- After each 10min, the screen will be flushed (once drawn black and white) to clear the display from ghosting - which is a common behavior of e-Paper screens.

## Landing:

- will be detected if groundspeed is less than <2m/s for 60 seconds.
- optional: you can force the vario to stop recording by press and hold both volume buttons for 1 second.
- The vario will now finish the IGC logging and display your flight statistics until any of the volume buttons is pressed for 1 second or a new takeoff has been detected.

#### ON THIS PAGE

- Pre-Takeoff: (https://epvario.github.io/usage/#pre-takeoff)
- Takeoff: (https://epvario.github.io/usage/#takeoff)
- Flying: (https://epvario.github.io/usage/#flying)
- Landing: (https://epvario.github.io/usage/#landing)
- Introduction (https://epvario.github.io/introduction)
- Features (https://epvario.github.io/features)
- Build Instructions (https://epvario.github.io/buildinstructions)
- Usage (https://epvario.github.io/usage)
- How To (https://epvario.github.io/howto)
- Configurator (https://epvario.github.io/config)
- Downloads (https://epvario.github.io/downloads)
  - Firmware (https://epvario.github.io/downloads/firmware)
  - AGL Data (https://epvario.github.io/downloads/agl)
  - Hardware (https://epvario.github.io/downloads/hardware)

Powered by Zola (https://www.getzola.org) and Goyo (https://github.com/hahwul/goyo)
